samyk/openraman/cuvettes/solid/2021-11_0 - COUPELLE ASSY.csv

Supplier | Ref | Label | Qty | Price | Price Tot
Thorlabs | SM05RR | SM05 Retaining Ring for Ø1/2" Lens Tubes and Mounts | 1 | € 3.75 | € 3.75
Materialize | #2021-10/0 | COUPELLE | 1 | € 14.15 | € 14.15
FIERS | PP58.1 | Micro-capsules en aluminium forme ronde 0.035 ml (250 pcs) | 0.004 | € 105.31 | € 0.42
