samyk/openraman/cuvettes/liquid/STEP/2020-10_1 - CUVETTE HOLDER ASSY.STEP

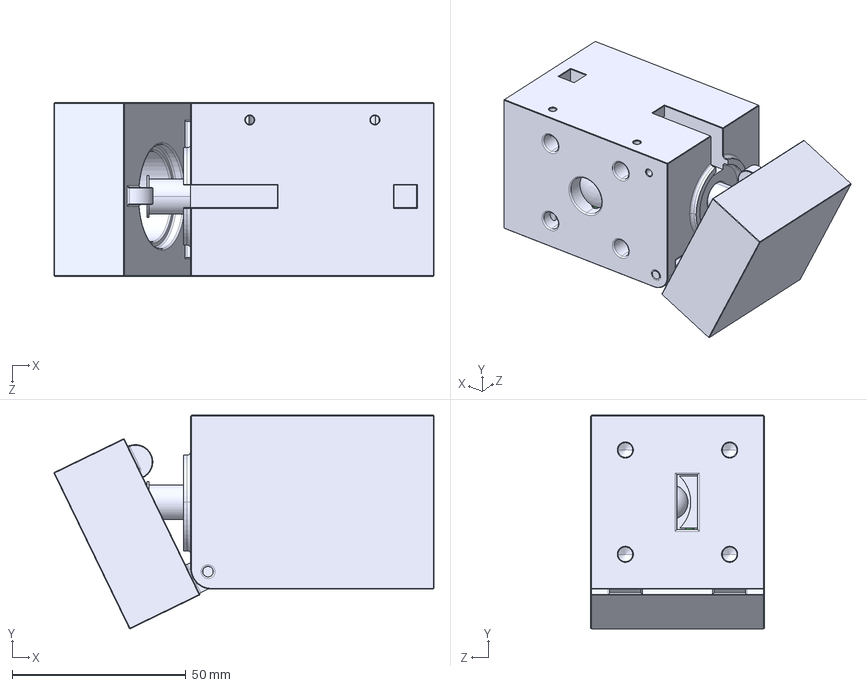
[picture p4: CAD file, 2023-12-25]
cuvettes/liquid/STEP/2020-10_1 - CUVETTE HOLDER ASSY.STEP
109.3 x 61.4 x 50.0 mm
2020-08 - CUVETTE HOLDER BODY
2020-11 - CUVETTE HOLDER OPTICAL DESIGN
2020-09 - CUVETTE HOLDER CAP
axis
tube
SS4MN4 x 2
