samyk/openraman/cuvettes/solid/STEP/2021-11_0 - COUPELLE ASSY.STEP

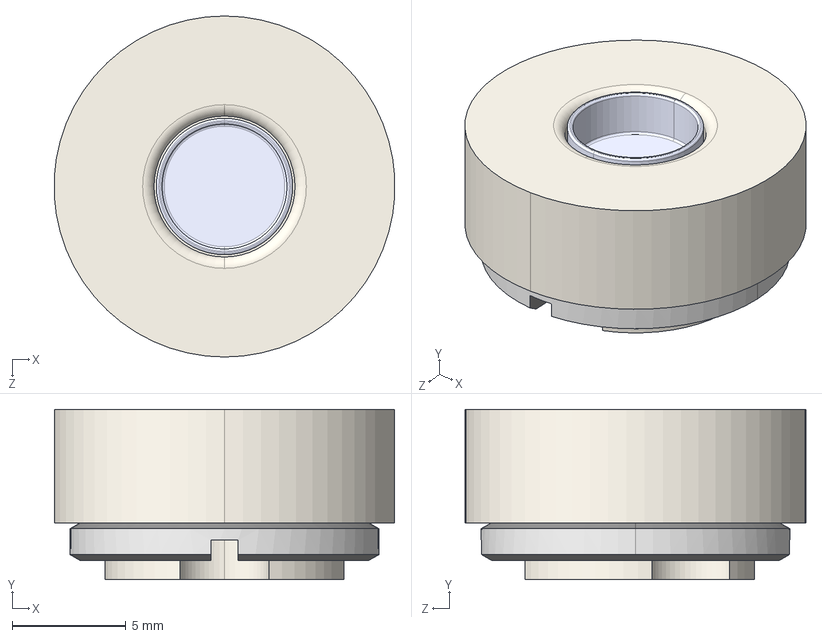
[picture p5: CAD file, 2023-12-25]
cuvettes/solid/STEP/2021-11_0 - COUPELLE ASSY.STEP
15.0 x 7.50 x 15.0 mm
2021-10 - COUPELLE
PP58.1
SM05RR
