samyk/openraman/cuvettes/liquid/STEP/2020-08_0 - CUVETTE HOLDER BODY.STEP

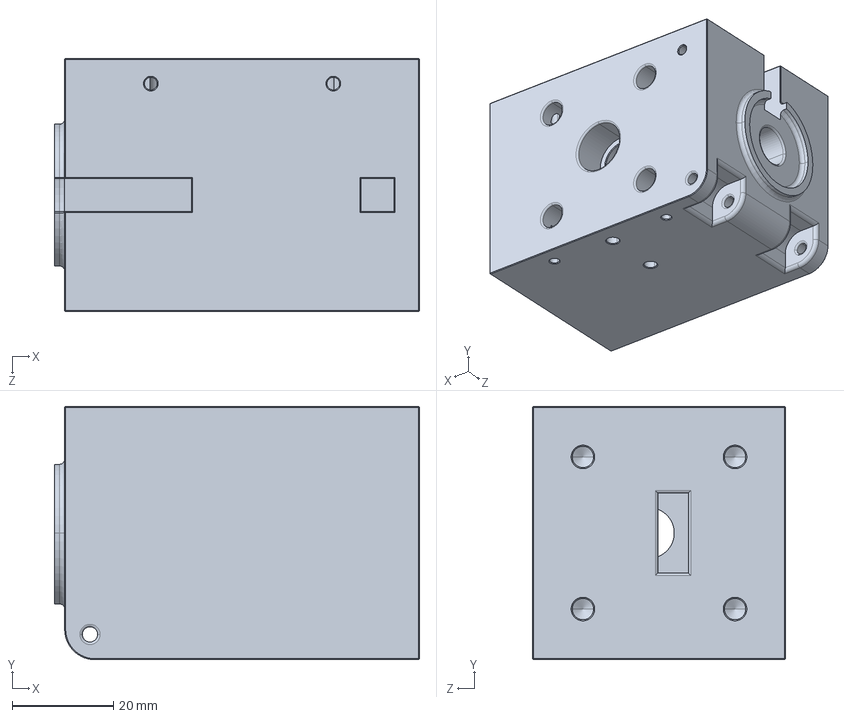
[picture p6: CAD file, 2023-12-25]
cuvettes/liquid/STEP/2020-08_0 - CUVETTE HOLDER BODY.STEP
72.0 x 50.0 x 50.0 mm
