samyk/openraman/cuvettes/solid/STEP/2021-10_0 - COUPELLE.STEP

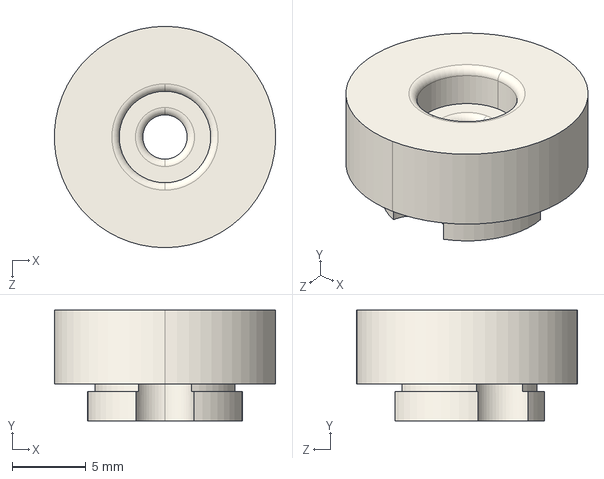
[picture p7: CAD file, 2023-12-25]
cuvettes/solid/STEP/2021-10_0 - COUPELLE.STEP
15.0 x 7.50 x 15.0 mm
