samyk/openraman/performance/STEP/2020-15_1 - GRATING HOLDER.STEP

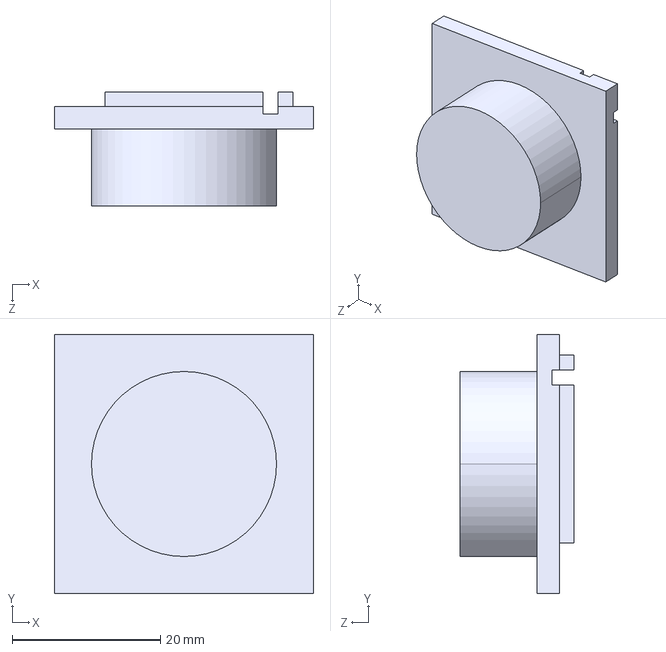
[picture p8: CAD file, 2023-12-25]
performance/STEP/2020-15_1 - GRATING HOLDER.STEP
35.0 x 35.0 x 15.4 mm
