samyk/openraman/cuvettes/solid/STEP/2021-13_0 - MICROMETER FLAT.STEP

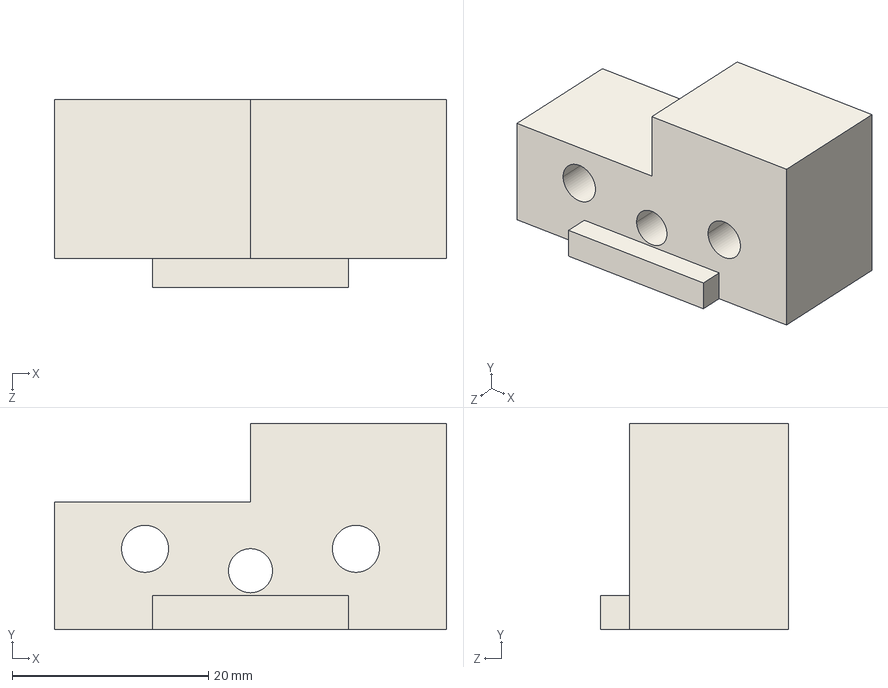
[picture p9: CAD file, 2023-12-25]
cuvettes/solid/STEP/2021-13_0 - MICROMETER FLAT.STEP
40.0 x 21.0 x 19.2 mm
