samyk/openraman/cuvettes/liquid/STEP/2020-09_0 - CUVETTE HOLDER CAP.STEP

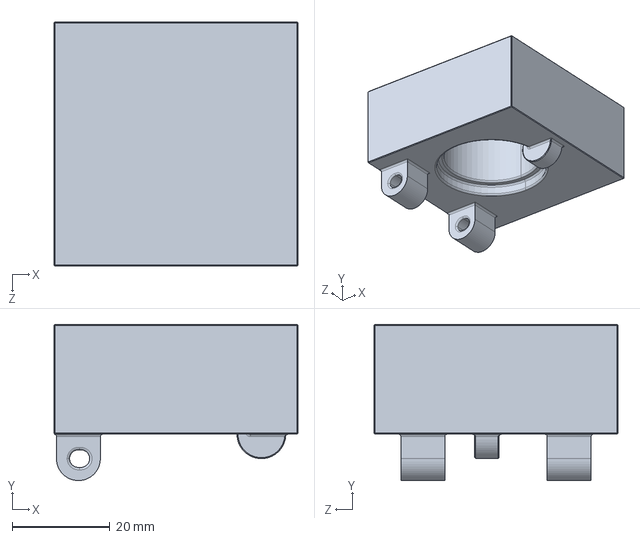
[picture p11: CAD file, 2023-12-25]
cuvettes/liquid/STEP/2020-09_0 - CUVETTE HOLDER CAP.STEP
50.0 x 32.0 x 50.0 mm
