samyk/openraman/cuvettes/solid/STEP/2021-12_0 - MICROMETER CLAMP.STEP

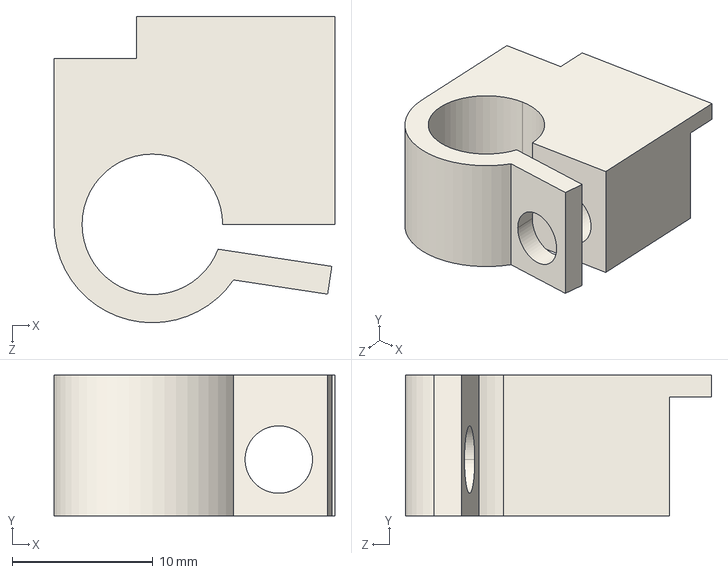
[picture p12: CAD file, 2023-12-25]
cuvettes/solid/STEP/2021-12_0 - MICROMETER CLAMP.STEP
20.0 x 10.0 x 21.8 mm
