samyk/openraman/performance/STEP/2020-20_1 - TO92 HEATSINK.STEP

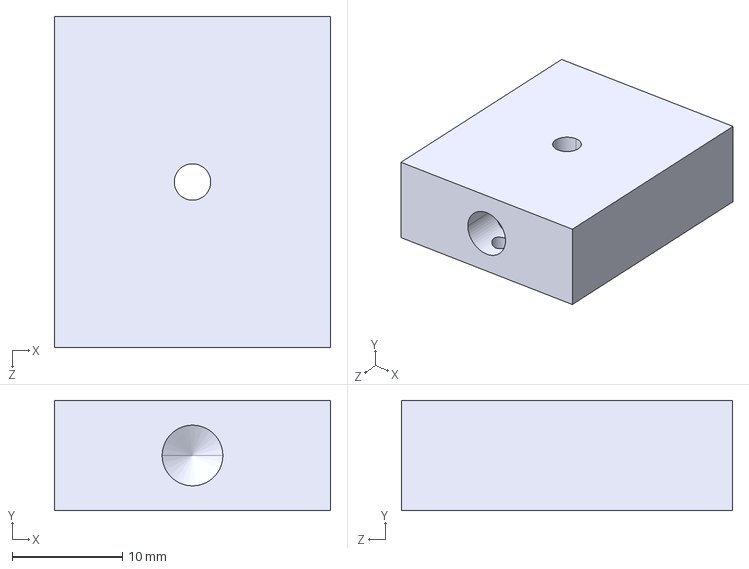
[picture p14: CAD file, 2023-12-25]
performance/STEP/2020-20_1 - TO92 HEATSINK.STEP
25.0 x 10.0 x 30.0 mm
