samyk/openraman/performance/STEP/2021-01_0 - CABLES FLEXTURE.STEP

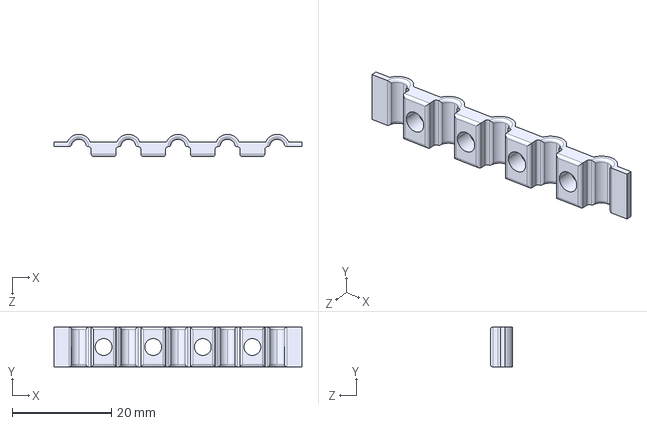
[picture p15: CAD file, 2023-12-25]
performance/STEP/2021-01_0 - CABLES FLEXTURE.STEP
50.0 x 8.00 x 4.50 mm
