samyk/openraman/performance/STEP/2020-02_2 - BASE PLATE.STEP

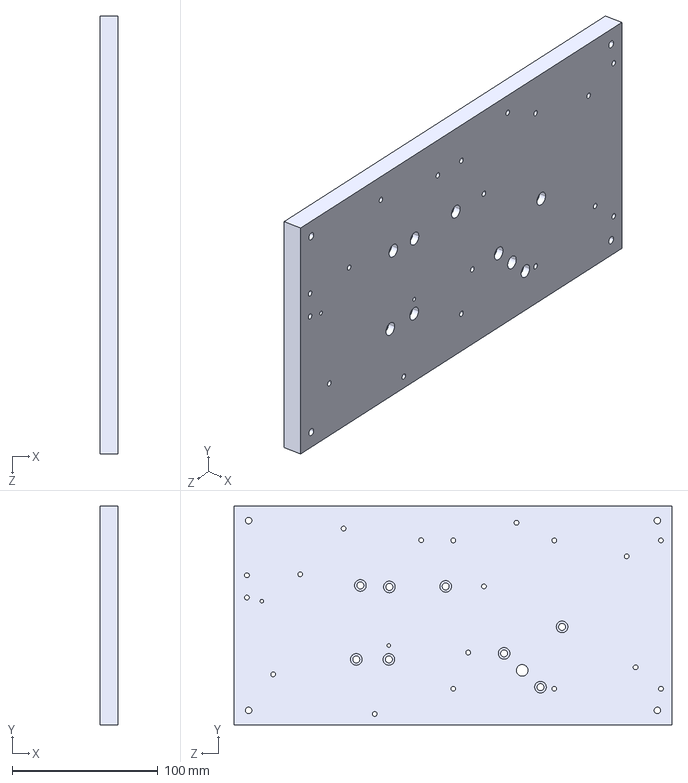
[picture p16: CAD file, 2023-12-25]
performance/STEP/2020-02_2 - BASE PLATE.STEP
12.0 x 150.0 x 300.0 mm
