samyk/openraman/performance/PDF/2020-02_2 - BASE PLATE.PDF

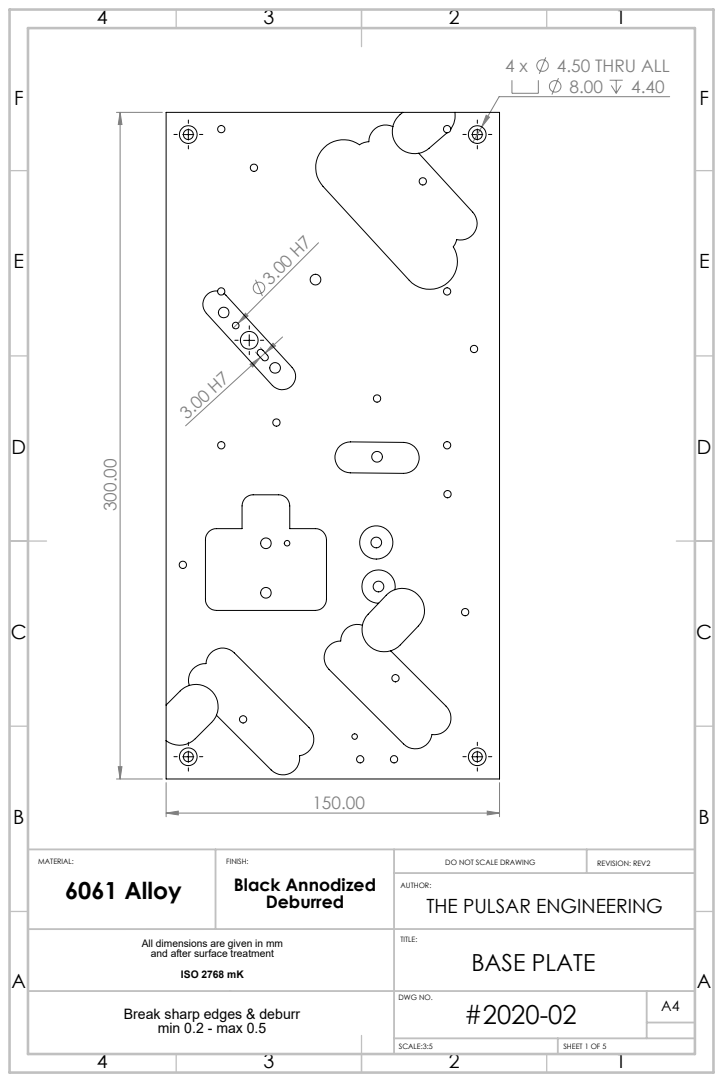
[picture p37: page 1]
4.50 THRU ALL; MATERIAL:; DO NOT SCALE DRAWING; REVISION: REV2; SCALE:3:5; SHEET 1 OF 5; 6061 Alloy; Black Annodized

AUTHOR:
THE PULSAR ENGINEERING

All dimensions are given in mm and after surface treatment ISO 2768 mK | TITLE: BASE PLATE

Break sharp edges & deburr min 0.2 - max 0.5 | DWG NO. | A4

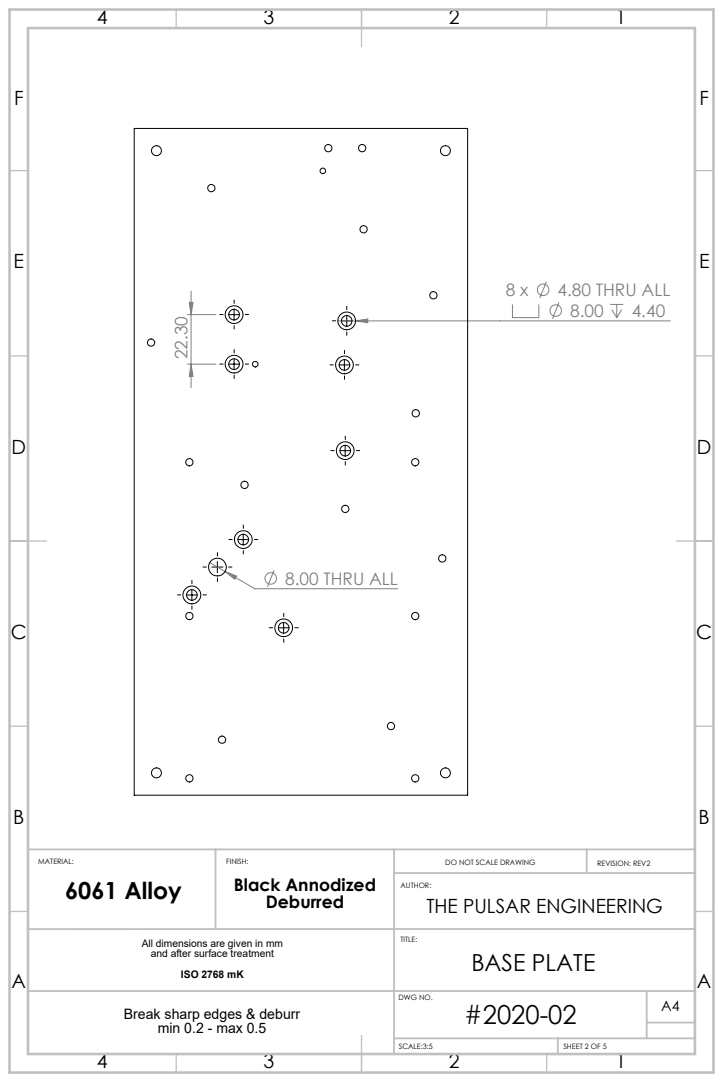
[picture p38: page 2]
4.80 THRU ALL; 8.00 THRU ALL; MATERIAL:; DO NOT SCALE DRAWING; REVISION: REV2; 6061 Alloy; Black Annodized

AUTHOR:
THE PULSAR ENGINEERING
BASE PLATE

All dimensions are given in mm
and after surface treatment
ISO 2768 mK

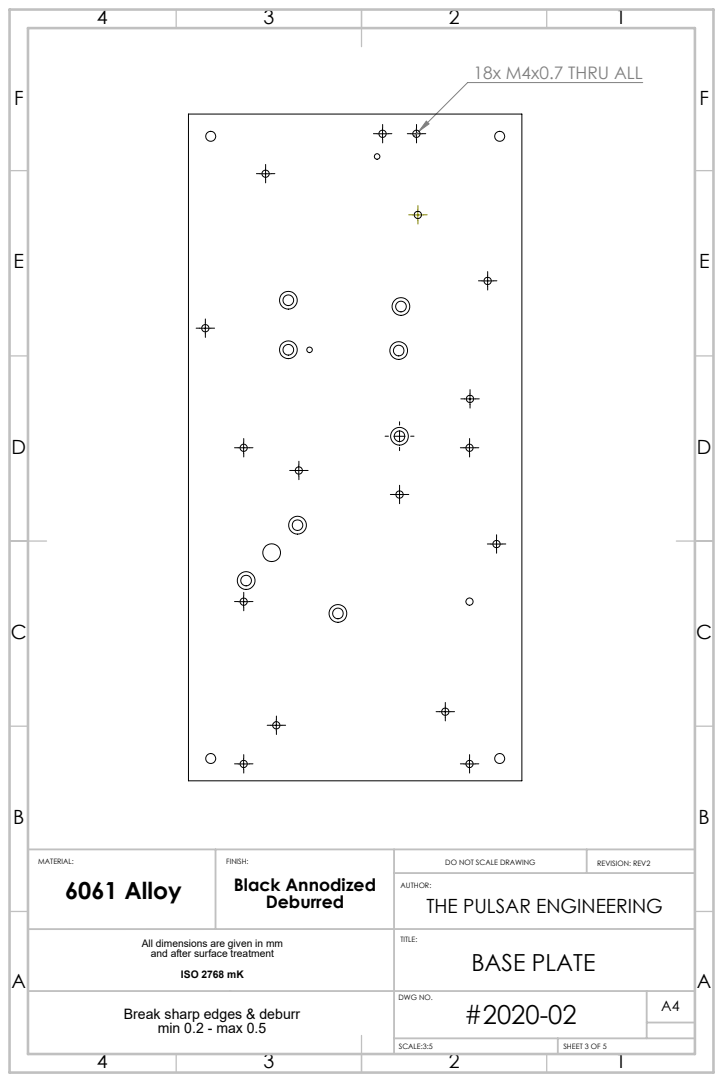
[picture p39: page 3]
18x M4x0.7 THRU ALL; MATERIAL:; DO NOT SCALE DRAWING; REVISION: REV2; 6061 Alloy; Black Annodized

AUTHOR:
THE PULSAR ENGINEERING
BASE PLATE

All dimensions are given in mm
and after surface treatment
ISO 2768 mK

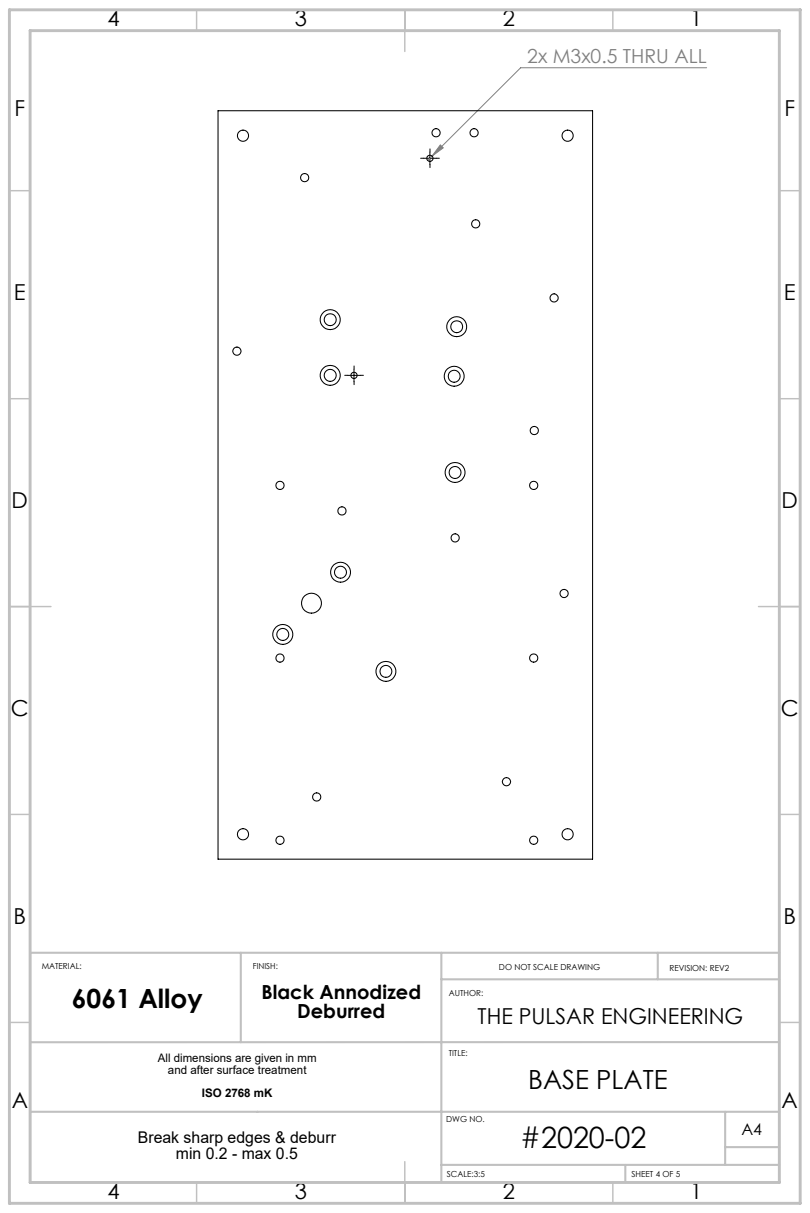
[picture p40: page 4]
2x M3x0.5 THRU ALL; MATERIAL:; DO NOT SCALE DRAWING; REVISION: REV2; 6061 Alloy; Black Annodized

AUTHOR:
THE PULSAR ENGINEERING
BASE PLATE

All dimensions are given in mm
and after surface treatment
ISO 2768 mK

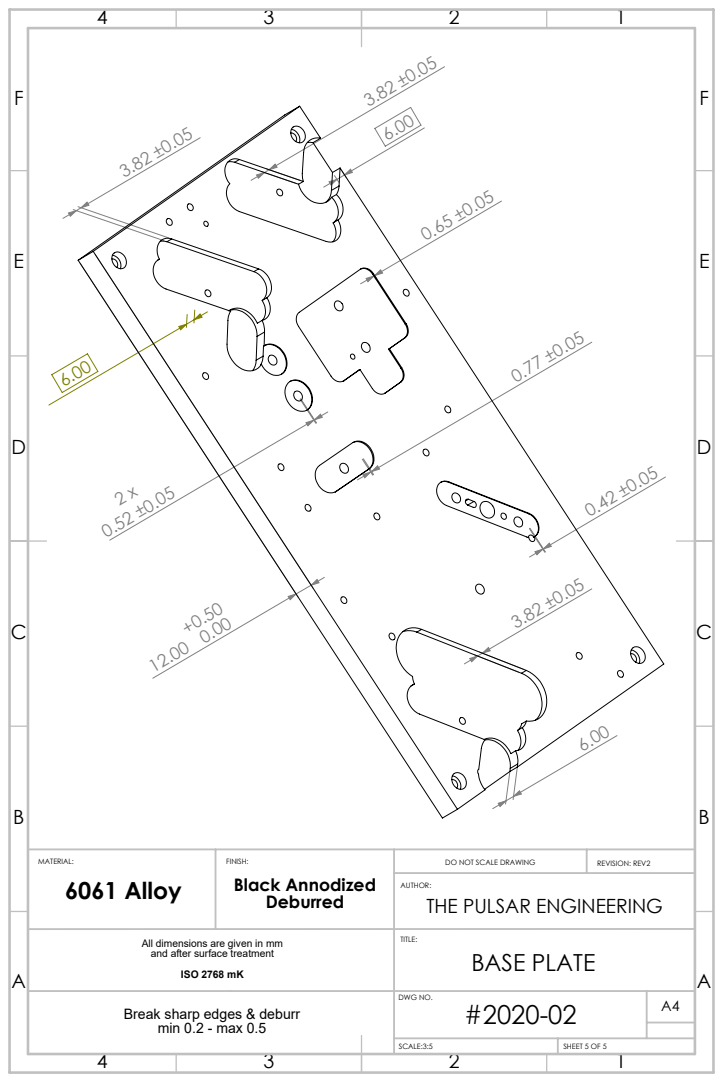
[picture p41: page 5]
MATERIAL:; DO NOT SCALE DRAWING; REVISION: REV2; 6061 Alloy; Black Annodized

AUTHOR:
THE PULSAR ENGINEERING
BASE PLATE

All dimensions are given in mm
and after surface treatment
ISO 2768 mK
