samyk/openraman/performance/PDF/2020-04_2 - PERFORMANCE EDITION ASSY.PDF

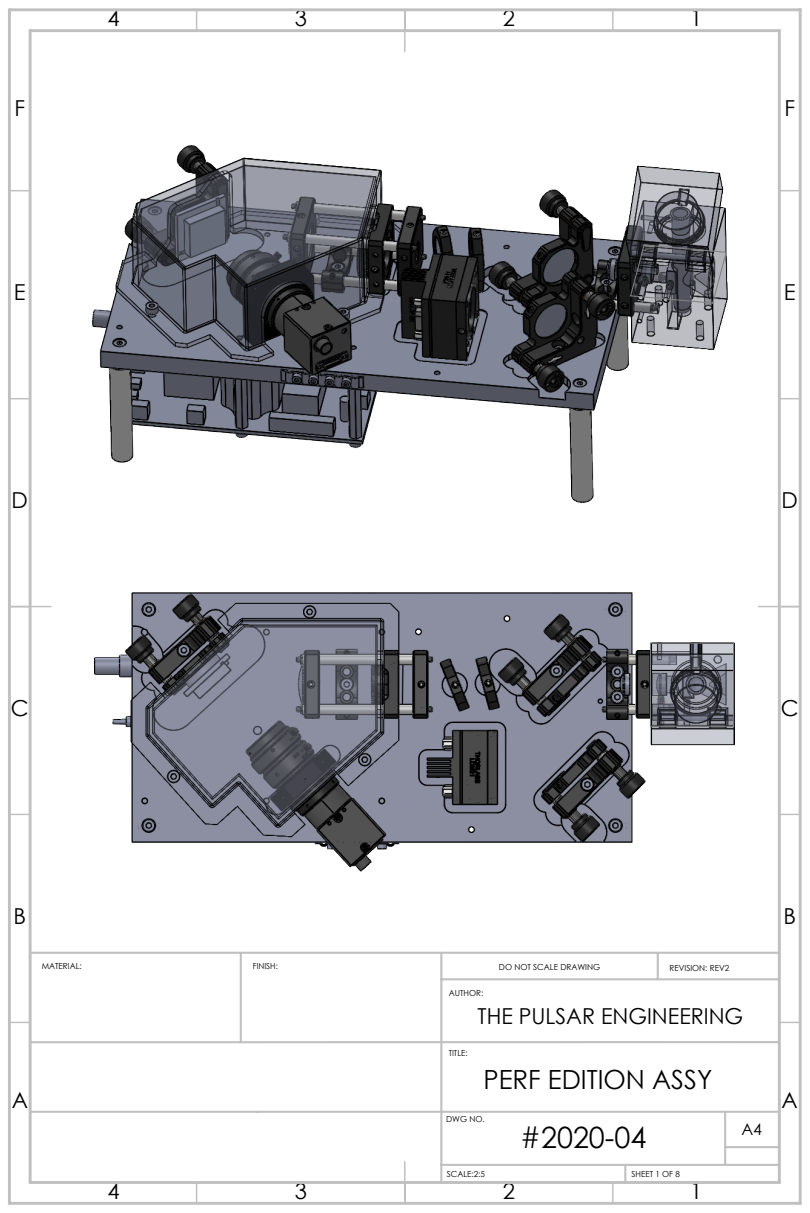
[picture p42: page 1]
MATERIAL:; FINISH:; DO NOT SCALE DRAWING; REVISION: REV2; SCALE:2:5; SHEET 1 OF 8

AUTHOR:
THE PULSAR ENGINEERING

TITLE: PERF EDITION ASSY

DWG NO. | A4

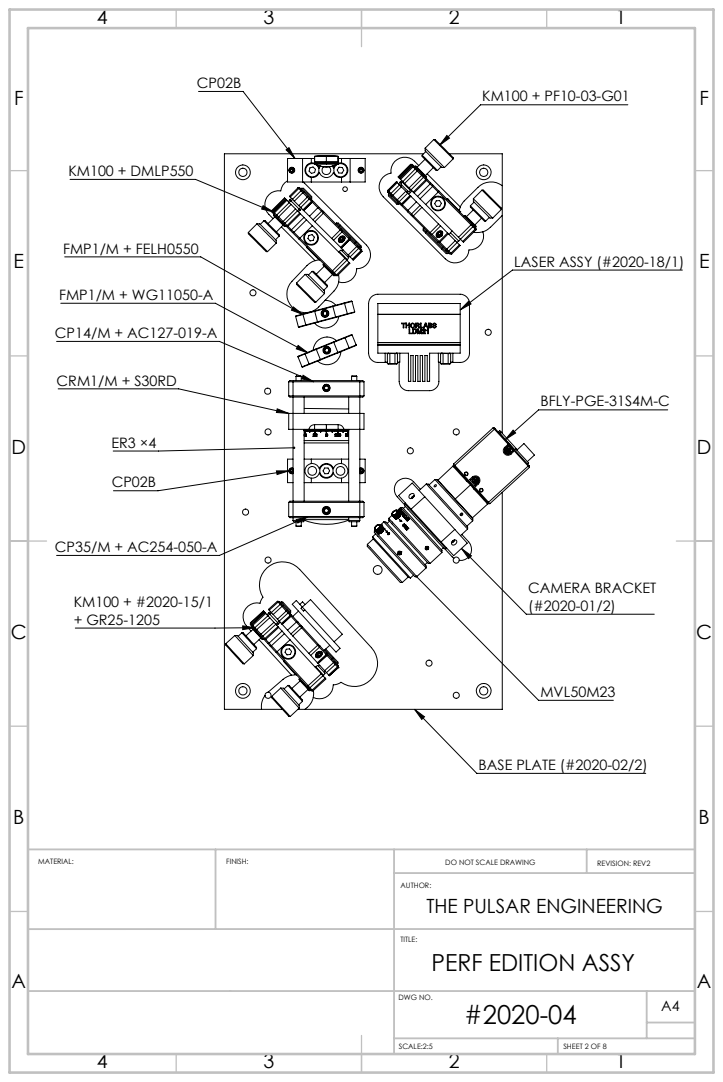
[picture p43: page 2]
LASER ASSY (#2020-18/1); CAMERA BRACKET; BASE PLATE (#2020-02/2); CRM1/M + S30RD; FMP1/M + WG11050-A; FMP1/M + FELH0550; KM100 + DMLP550; MATERIAL:; FINISH:; DO NOT SCALE DRAWING; REVISION: REV2

AUTHOR:
THE PULSAR ENGINEERING
PERF EDITION ASSY

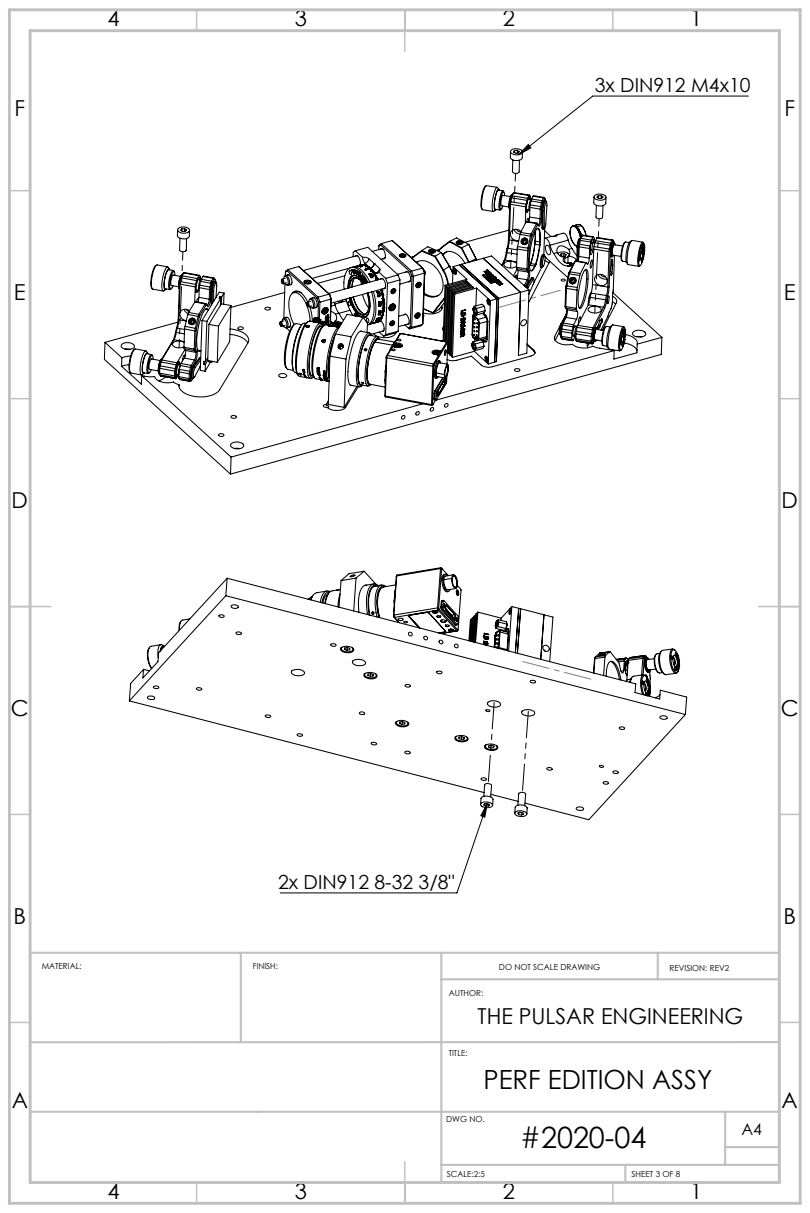
[picture p44: page 3]
3x DIN912 M4x10; 2x DIN912 8-32 3/8"; MATERIAL:; FINISH:; DO NOT SCALE DRAWING; REVISION: REV2

AUTHOR:
THE PULSAR ENGINEERING
PERF EDITION ASSY

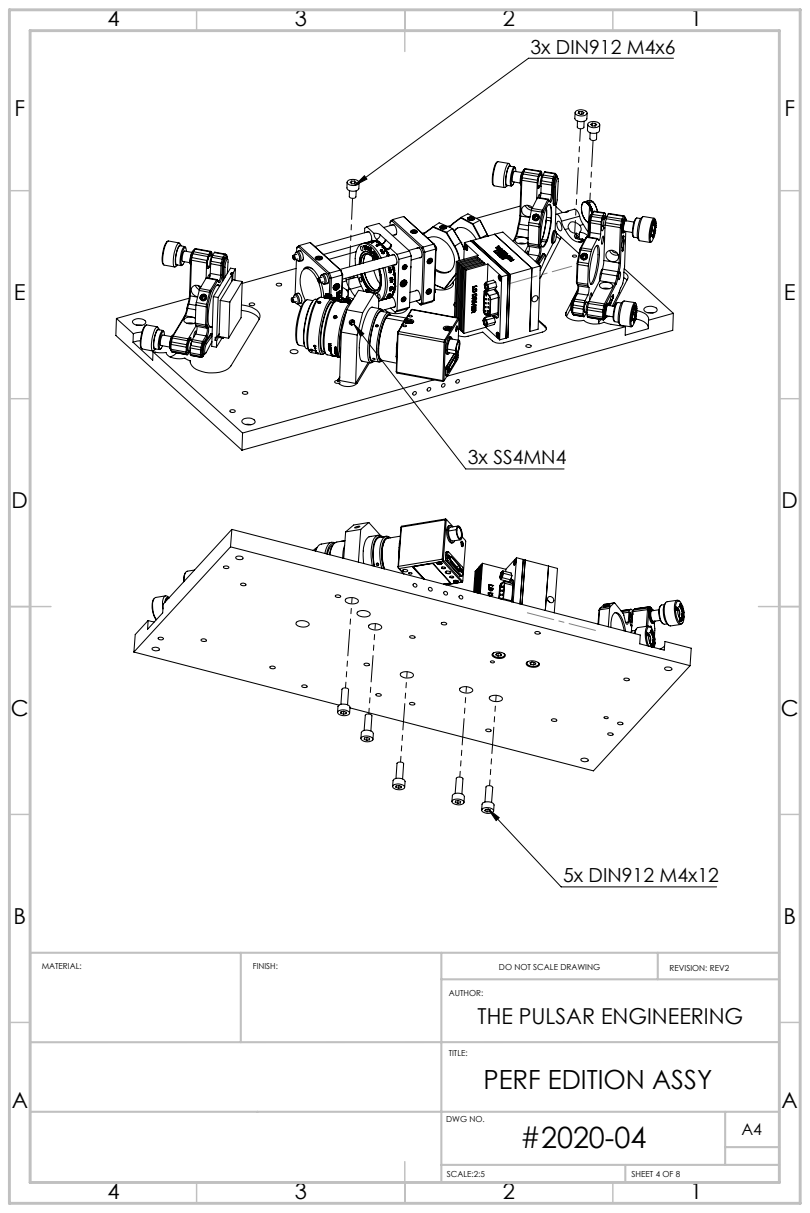
[picture p45: page 4]
3x DIN912 M4x6; 5x DIN912 M4x12; MATERIAL:; FINISH:; DO NOT SCALE DRAWING; REVISION: REV2

AUTHOR:
THE PULSAR ENGINEERING
PERF EDITION ASSY

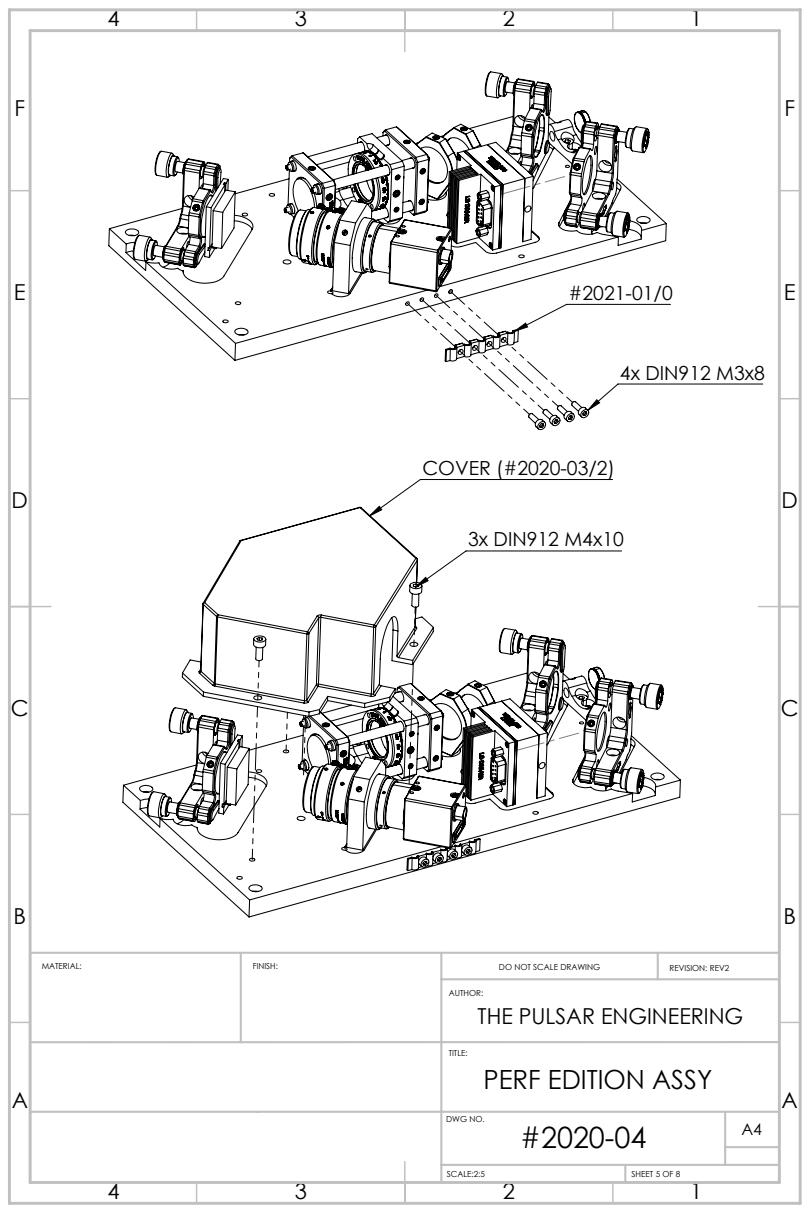
[picture p46: page 5]
4x DIN912 M3x8; COVER (#2020-03/2); 3x DIN912 M4x10; MATERIAL:; FINISH:; DO NOT SCALE DRAWING; REVISION: REV2

AUTHOR:
THE PULSAR ENGINEERING
PERF EDITION ASSY

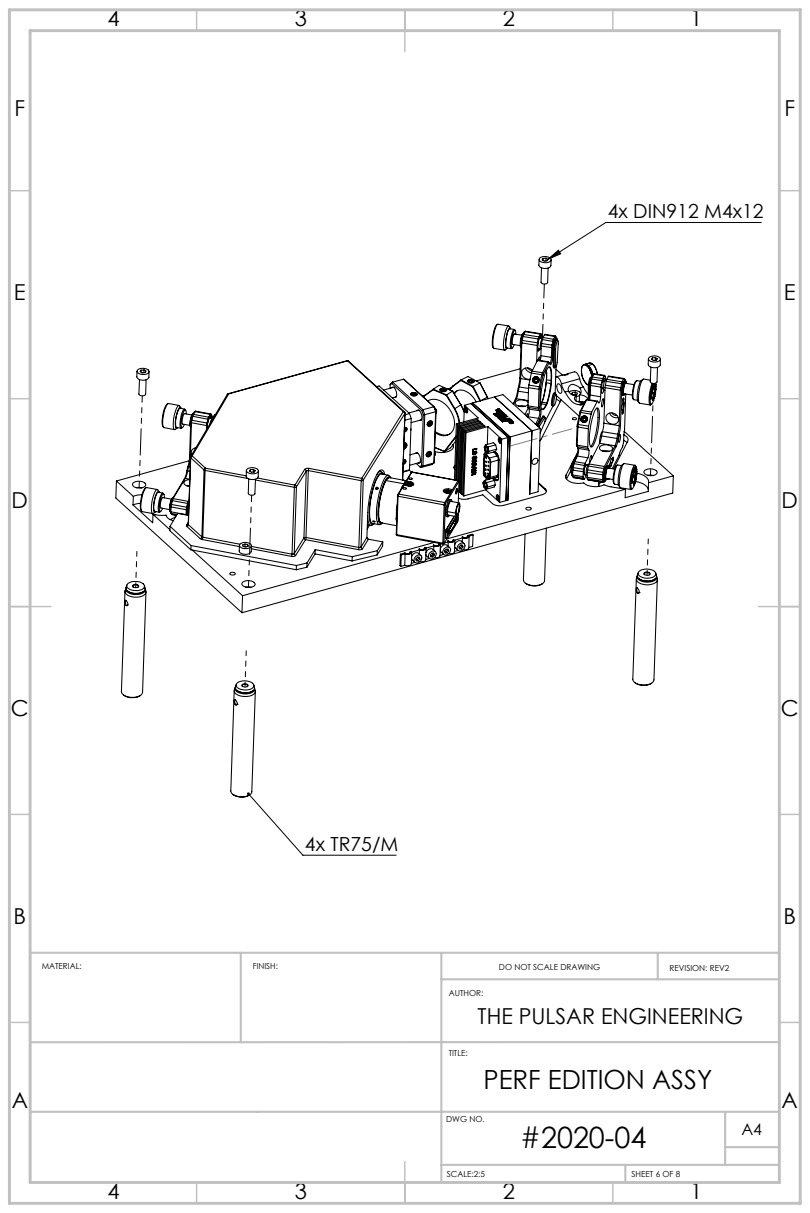
[picture p47: page 6]
4x DIN912 M4x12; MATERIAL:; FINISH:; DO NOT SCALE DRAWING; REVISION: REV2

AUTHOR:
THE PULSAR ENGINEERING
PERF EDITION ASSY

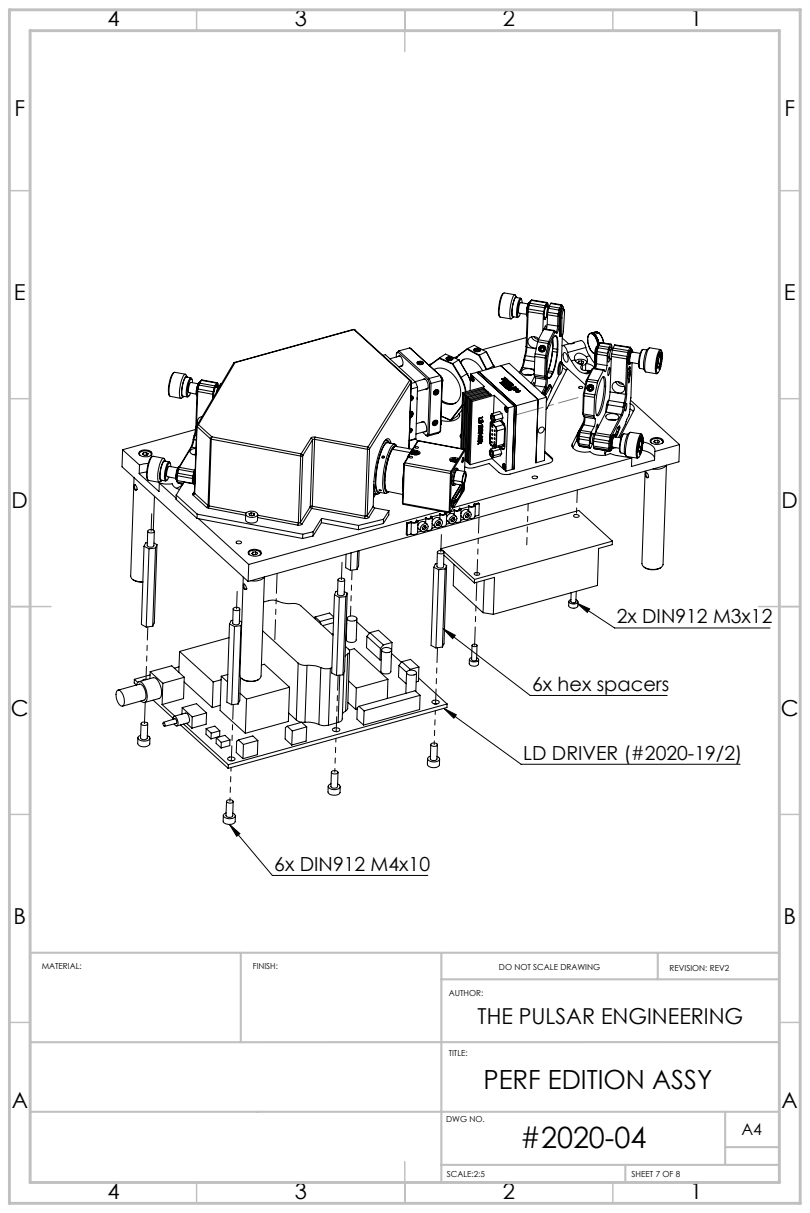
[picture p48: page 7]
LD DRIVER (#2020-19/2); 2x DIN912 M3x12; 6x DIN912 M4x10; 6x hex spacers; MATERIAL:; FINISH:; DO NOT SCALE DRAWING; REVISION: REV2

AUTHOR:
THE PULSAR ENGINEERING
PERF EDITION ASSY

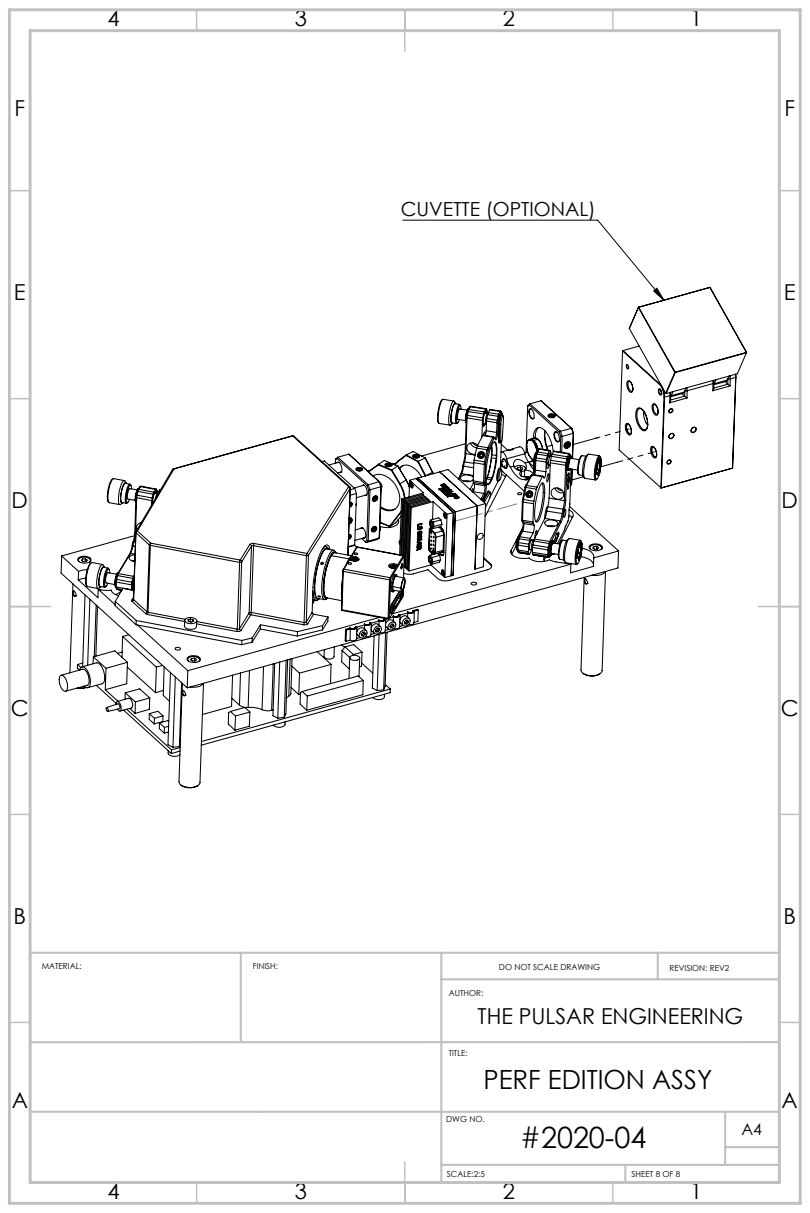
[picture p49: page 8]
CUVETTE (OPTIONAL); MATERIAL:; FINISH:; DO NOT SCALE DRAWING; REVISION: REV2

AUTHOR:
THE PULSAR ENGINEERING
PERF EDITION ASSY
