samyk/openraman/performance/PDF/2020-15_1 - GRATING HOLDER.PDF

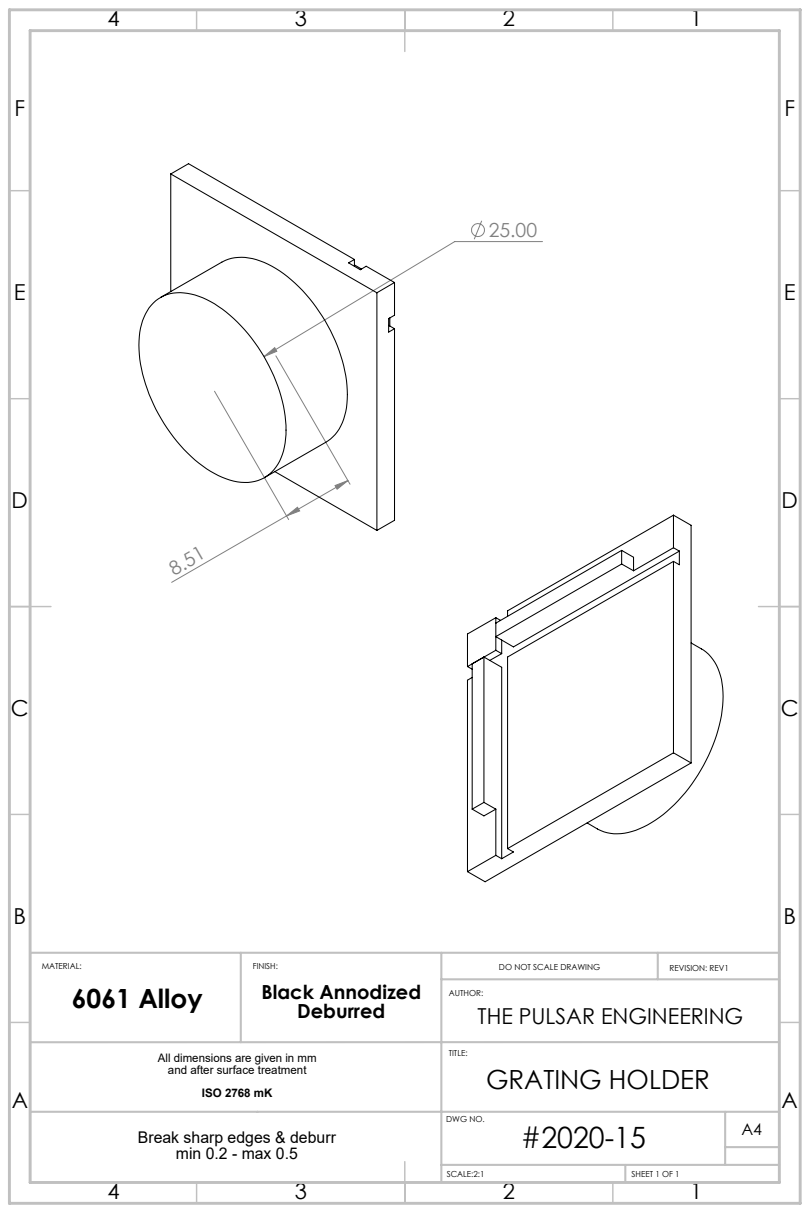
[picture p51: page 1]
MATERIAL:; DO NOT SCALE DRAWING; REVISION: REV1; SCALE:2:1; SHEET 1 OF 1; 6061 Alloy; Black Annodized

AUTHOR:
THE PULSAR ENGINEERING

All dimensions are given in mm and after surface treatment ISO 2768 mK | TITLE: GRATING HOLDER

Break sharp edges & deburr min 0.2 - max 0.5 | DWG NO. #2020-15 | A4
