samyk/openraman/performance/PDF/2020-18_1 - LASER ASSY.PDF

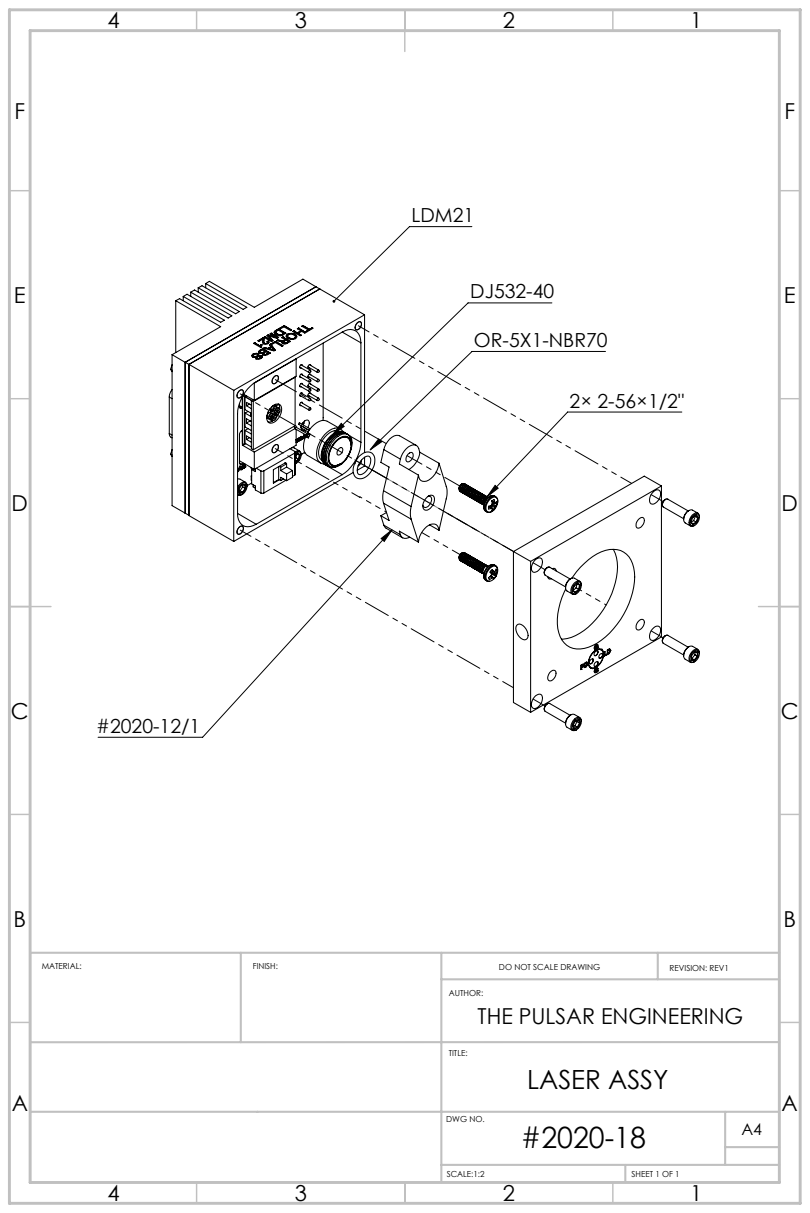
[picture p52: page 1]
MATERIAL:; FINISH:; DO NOT SCALE DRAWING; REVISION: REV1; SCALE:1:2; SHEET 1 OF 1

AUTHOR:
THE PULSAR ENGINEERING

TITLE: LASER ASSY

DWG NO. #2020-18 | A4
