samyk/openraman/performance/PDF/2020-19_2 - LD DRIVER IC.pdf

J1

## INTERLOCK

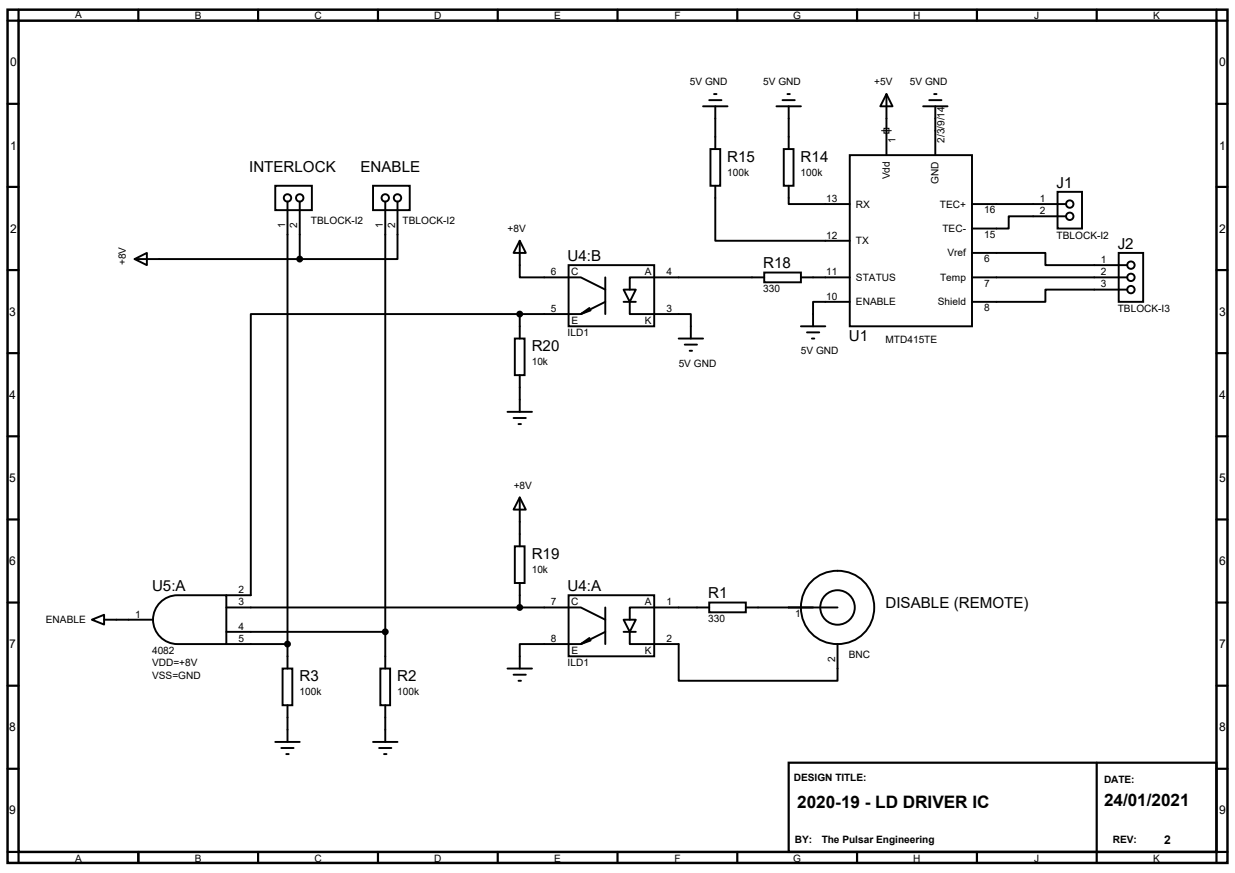
[picture p53: page 1]

5V GND 5V GND +5V 5V GND

C1

## FAN1

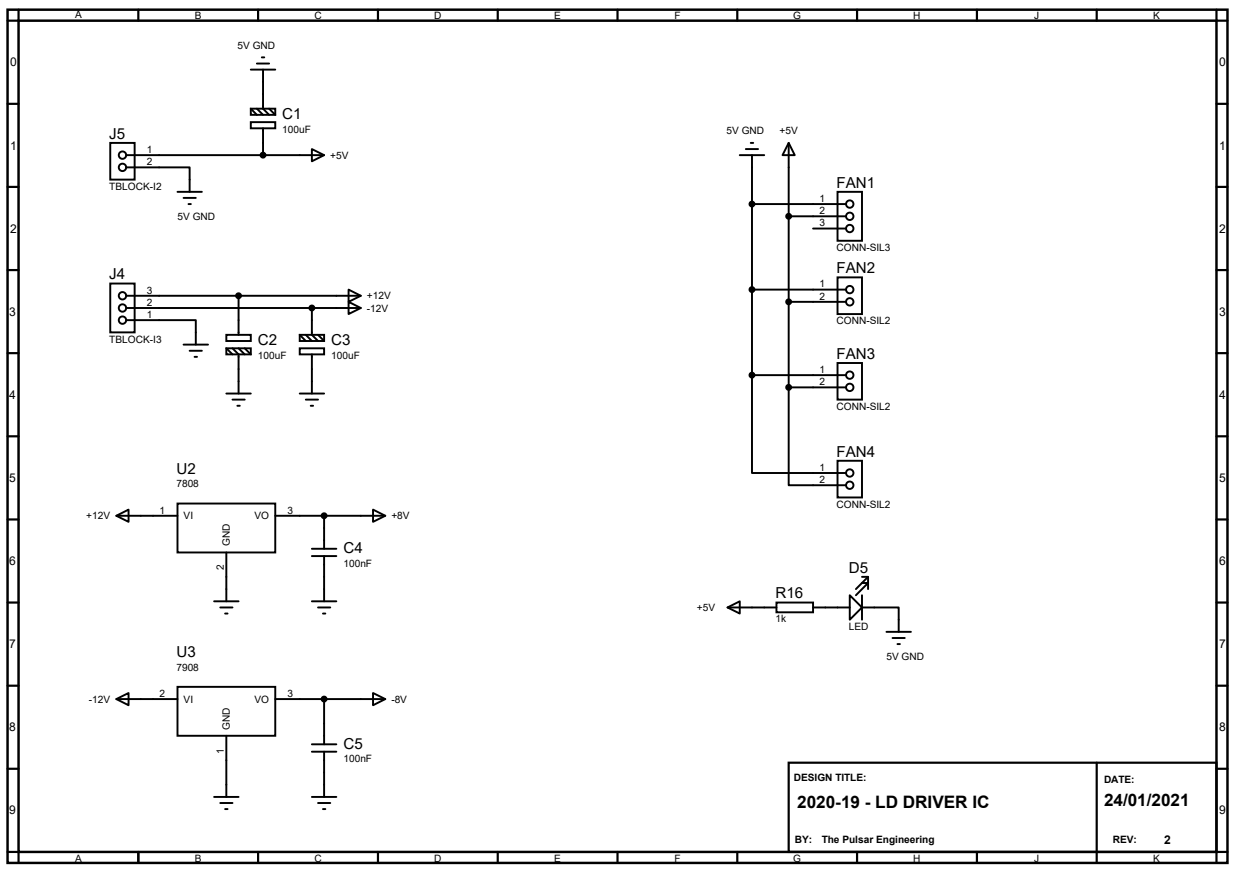
[picture p54: page 2]

R4

D6

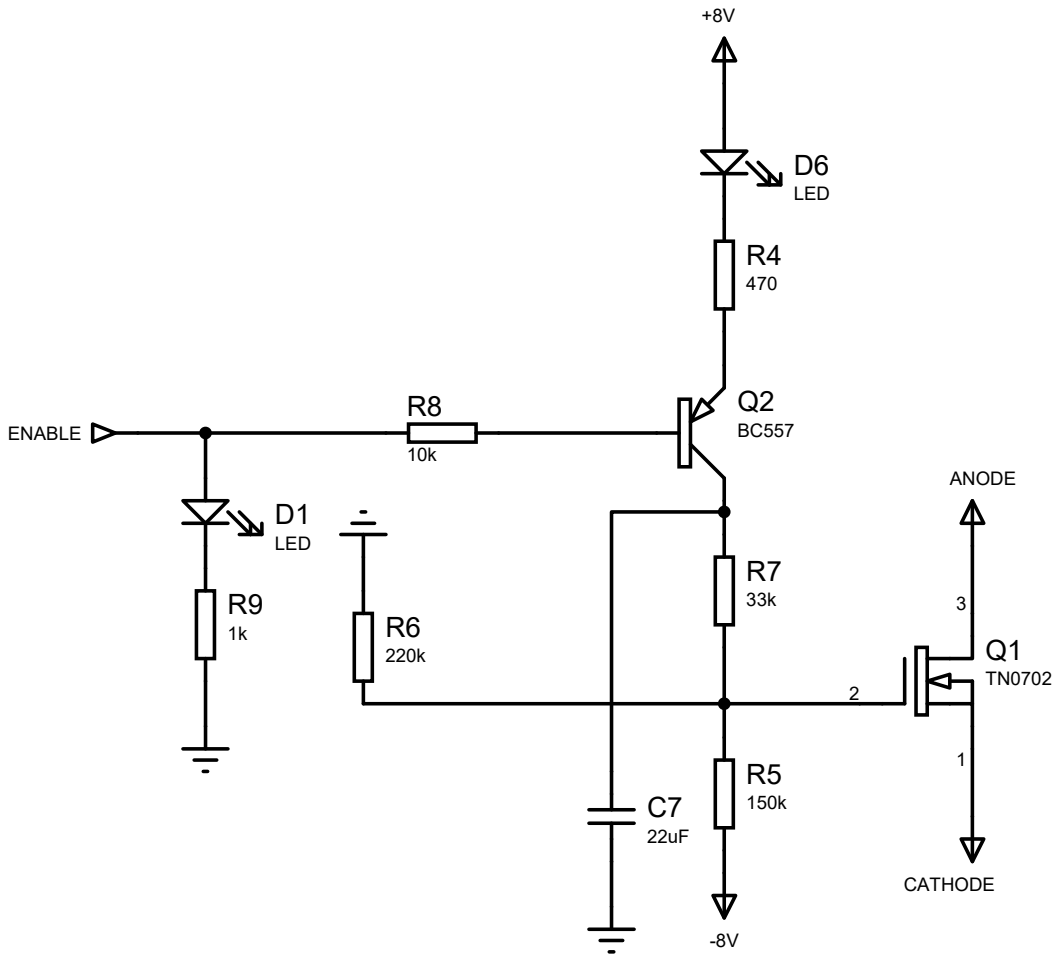
[picture p55: page 3]

U6

C8

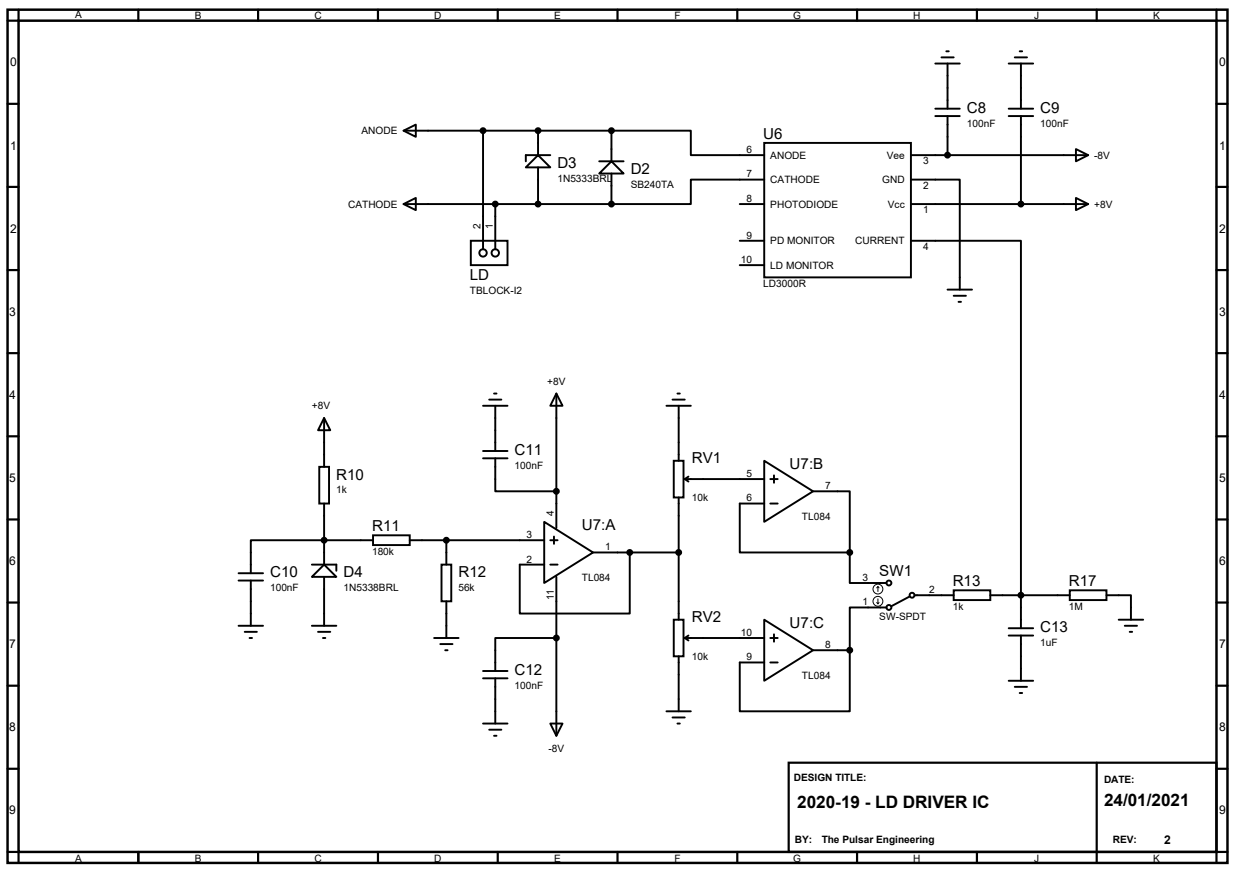
[picture p56: page 4]
