samyk/openraman/performance/PDF/2020-20_1 - TO92 HEATSINK.PDF

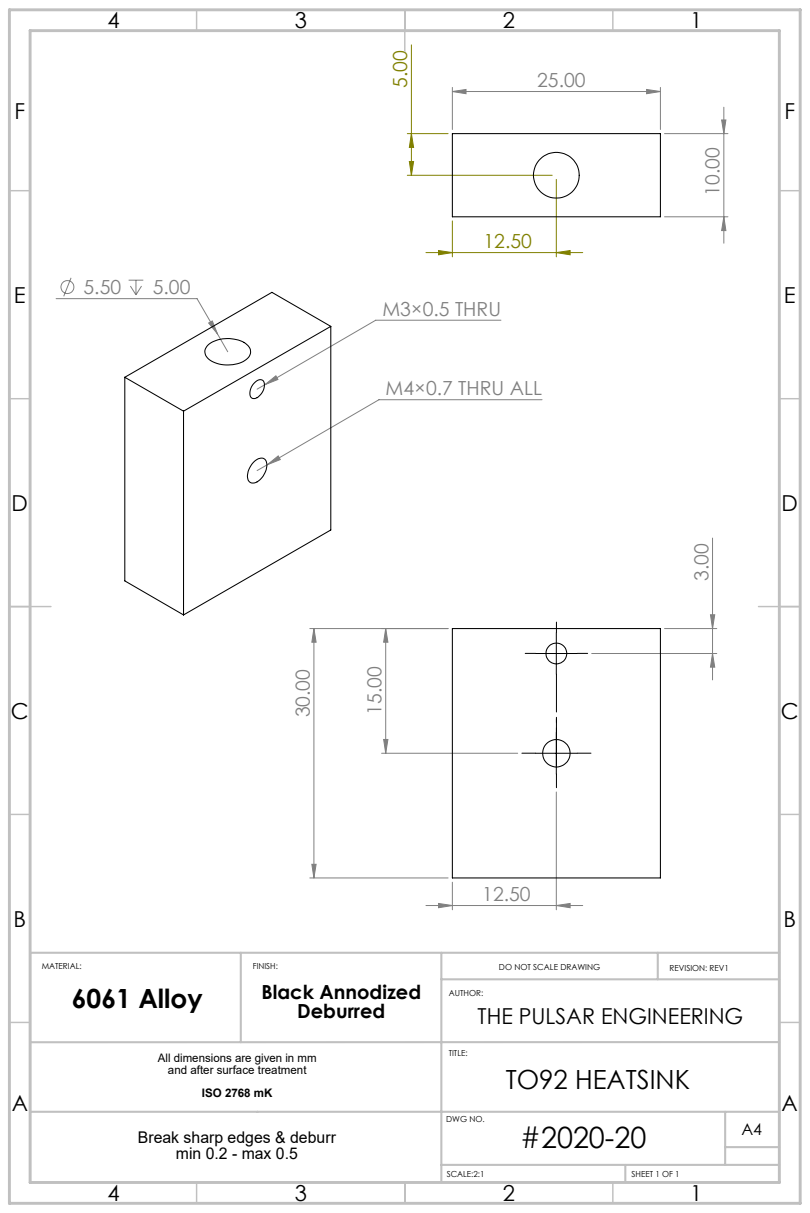
[picture p57: page 1]
M3×0.5 THRU; M4×0.7 THRU ALL; MATERIAL:; DO NOT SCALE DRAWING; REVISION: REV1; SCALE:2:1; SHEET 1 OF 1; 6061 Alloy; Black Annodized

AUTHOR:
THE PULSAR ENGINEERING

All dimensions are given in mm and after surface treatment ISO 2768 mK | TITLE: TO92 HEATSINK

Break sharp edges & deburr min 0.2 - max 0.5 | DWG NO. #2020-20 | A4
