samyk/openraman/performance/PDF/2021-01_0 - CABLES FLEXTURE.PDF

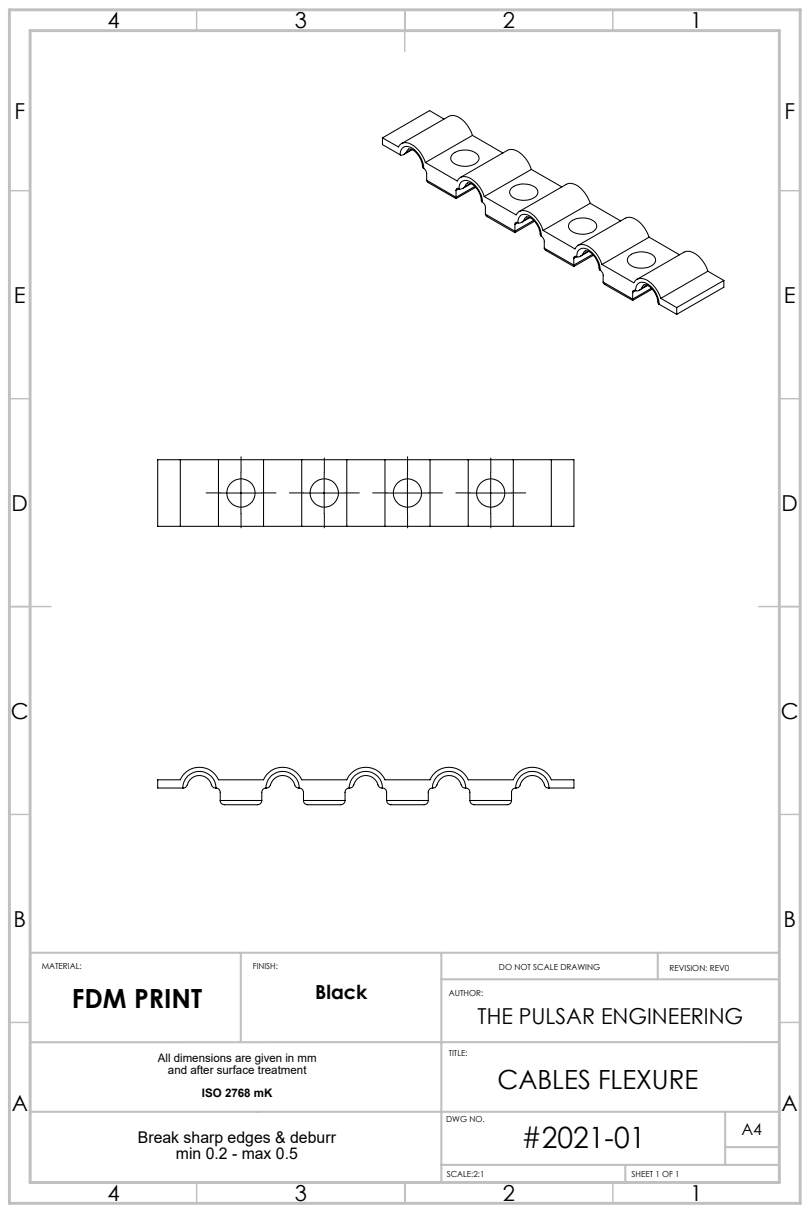
[picture p58: page 1]
MATERIAL:; DO NOT SCALE DRAWING; REVISION: REV0; SCALE:2:1; SHEET 1 OF 1; FDM PRINT; Black

AUTHOR:
THE PULSAR ENGINEERING

All dimensions are given in mm and after surface treatment ISO 2768 mK | TITLE: CABLES FLEXURE

Break sharp edges & deburr min 0.2 - max 0.5 | DWG NO. #2021-01 | A4
