samyk/openraman/cuvettes/liquid/PDF/2020-08_0 - CUVETTE HOLDER BODY.PDF

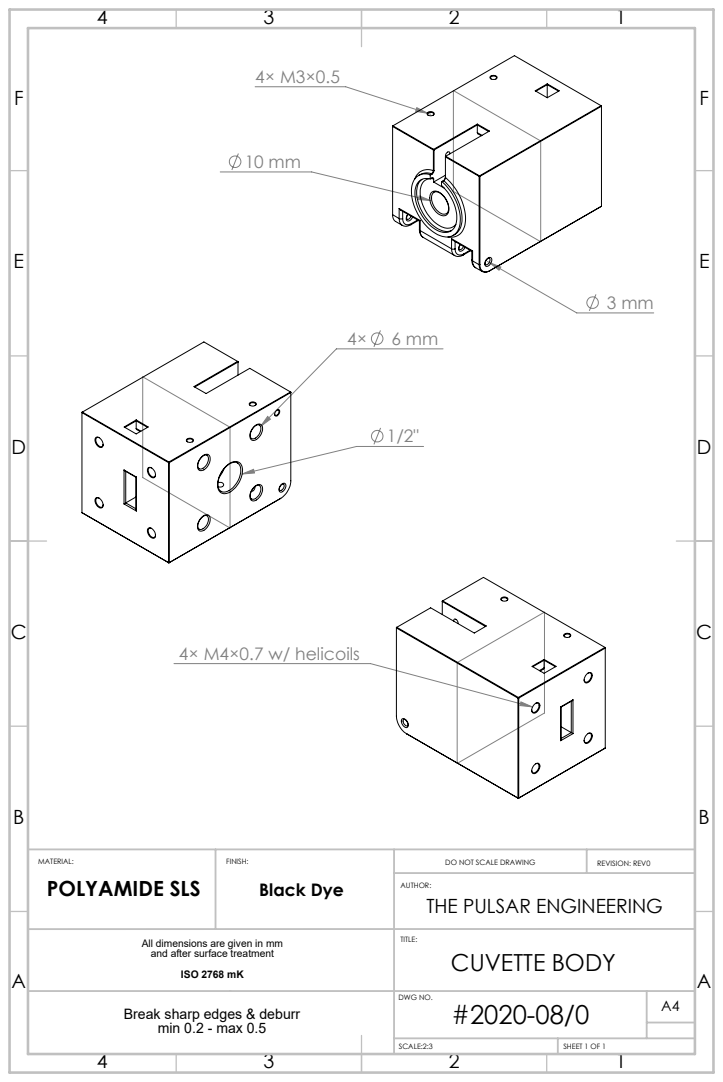
[picture p59: page 1]
4× M4×0.7 w/ helicoils; MATERIAL:; DO NOT SCALE DRAWING; REVISION: REV0; SCALE:2:3; SHEET 1 OF 1; POLYAMIDE SLS; Black Dye

AUTHOR:
THE PULSAR ENGINEERING

All dimensions are given in mm and after surface treatment ISO 2768 mK | TITLE: CUVETTE BODY

Break sharp edges & deburr min 0.2 - max 0.5 | DWG NO. #2020-08/0 | A4
