samyk/openraman/cuvettes/liquid/PDF/2020-10_1 - CUVETTE HOLDER ASSY.PDF

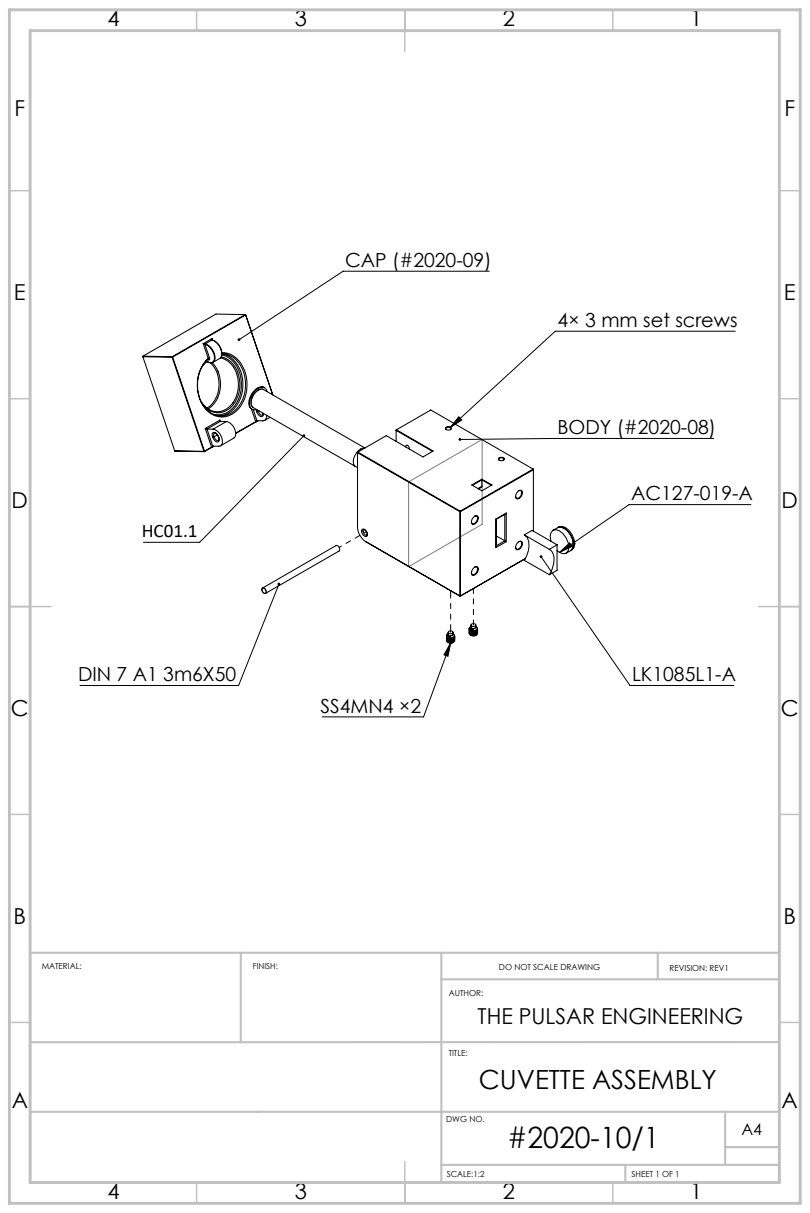
[picture p60: page 1]
CAP (#2020-09); BODY (#2020-08); DIN 7 A1 3m6X50; MATERIAL:; FINISH:; DO NOT SCALE DRAWING; REVISION: REV1; SCALE:1:2; SHEET 1 OF 1

4× 3 mm set screws

AUTHOR:
THE PULSAR ENGINEERING

TITLE: CUVETTE ASSEMBLY

DWG NO. #2020-10/1 | A4
