samyk/openraman/cuvettes/solid/PDF/2021-09_0 - SOLID ASSY.pdf

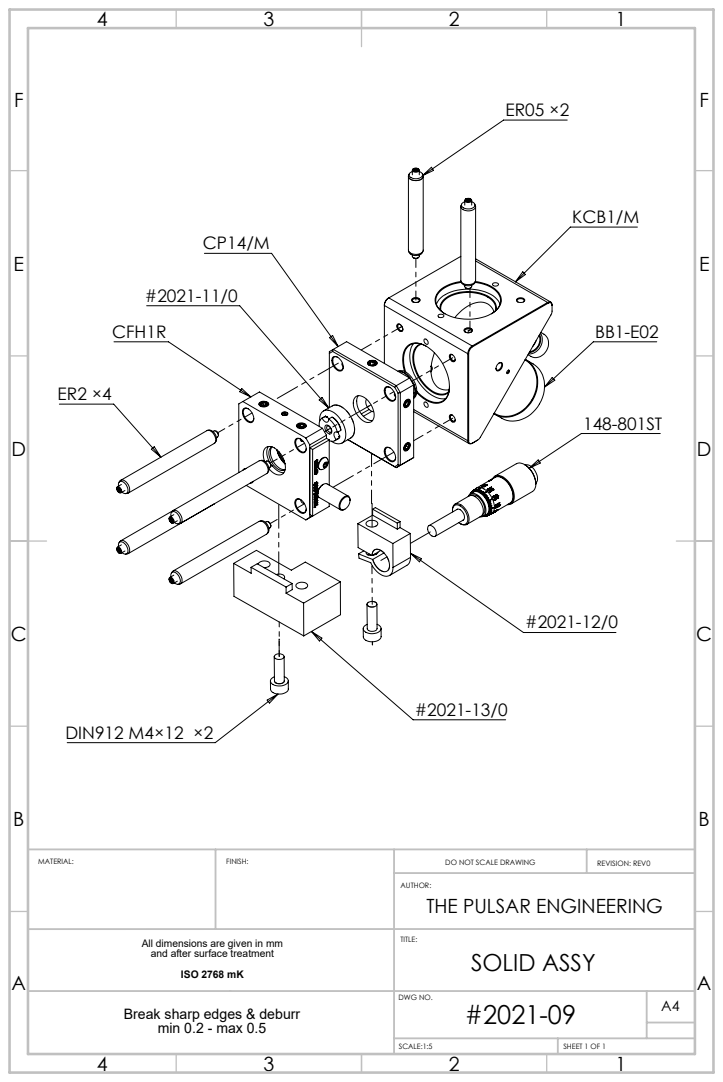
[picture p61: page 1]
DIN912 M4×12 ×2; MATERIAL:; DO NOT SCALE DRAWING; REVISION: REV0; SCALE:1:5; SHEET 1 OF 1

AUTHOR:
THE PULSAR ENGINEERING

All dimensions are given in mm and after surface treatment ISO 2768 mK | TITLE: SOLID ASSY

Break sharp edges & deburr min 0.2 - max 0.5 | DWG NO. #2021-09 | A4
