samyk/openraman/cuvettes/solid/PDF/2021-10_0 - COUPELLE.pdf

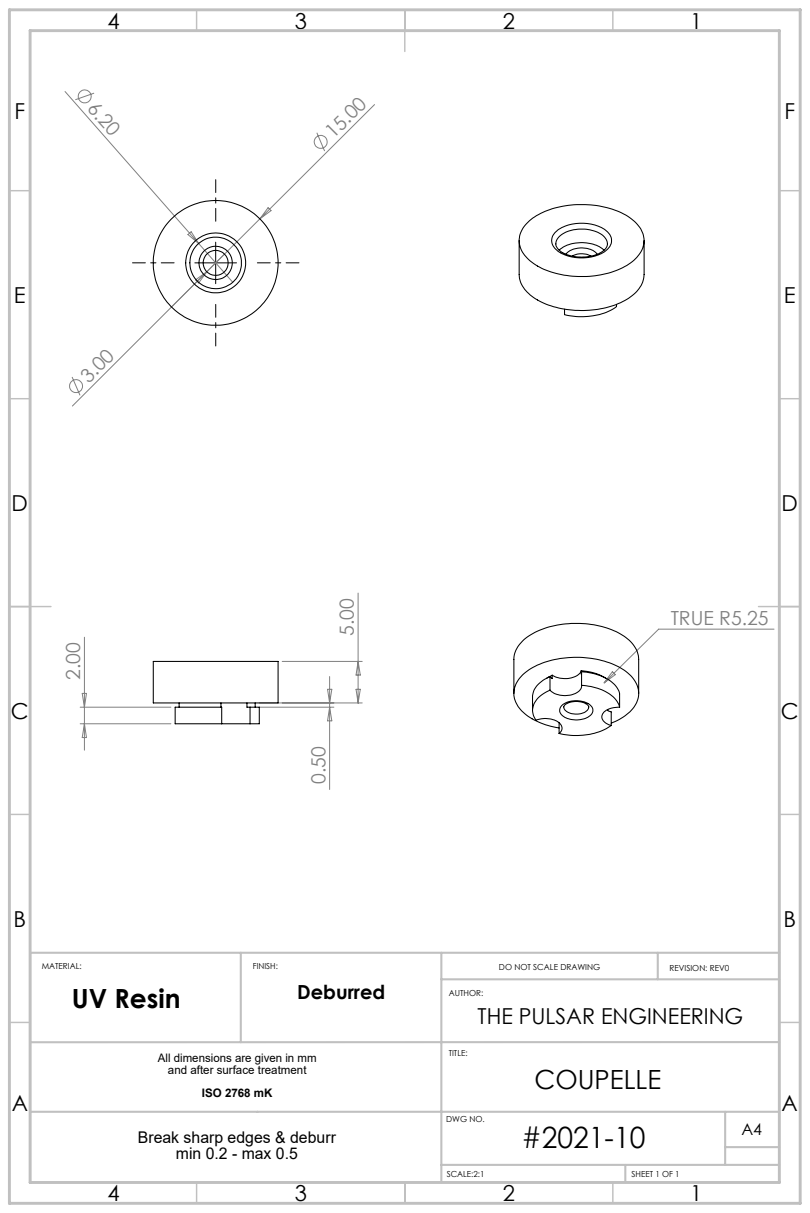
[picture p62: page 1]
TRUE R5.25; MATERIAL:; DO NOT SCALE DRAWING; REVISION: REV0; SCALE:2:1; SHEET 1 OF 1; UV Resin; Deburred

AUTHOR:
THE PULSAR ENGINEERING

All dimensions are given in mm and after surface treatment ISO 2768 mK | TITLE: COUPELLE

Break sharp edges & deburr min 0.2 - max 0.5 | DWG NO. #2021-10 | A4
