samyk/openraman/cuvettes/solid/PDF/2021-13_0 - MICROMETER FLAT.pdf

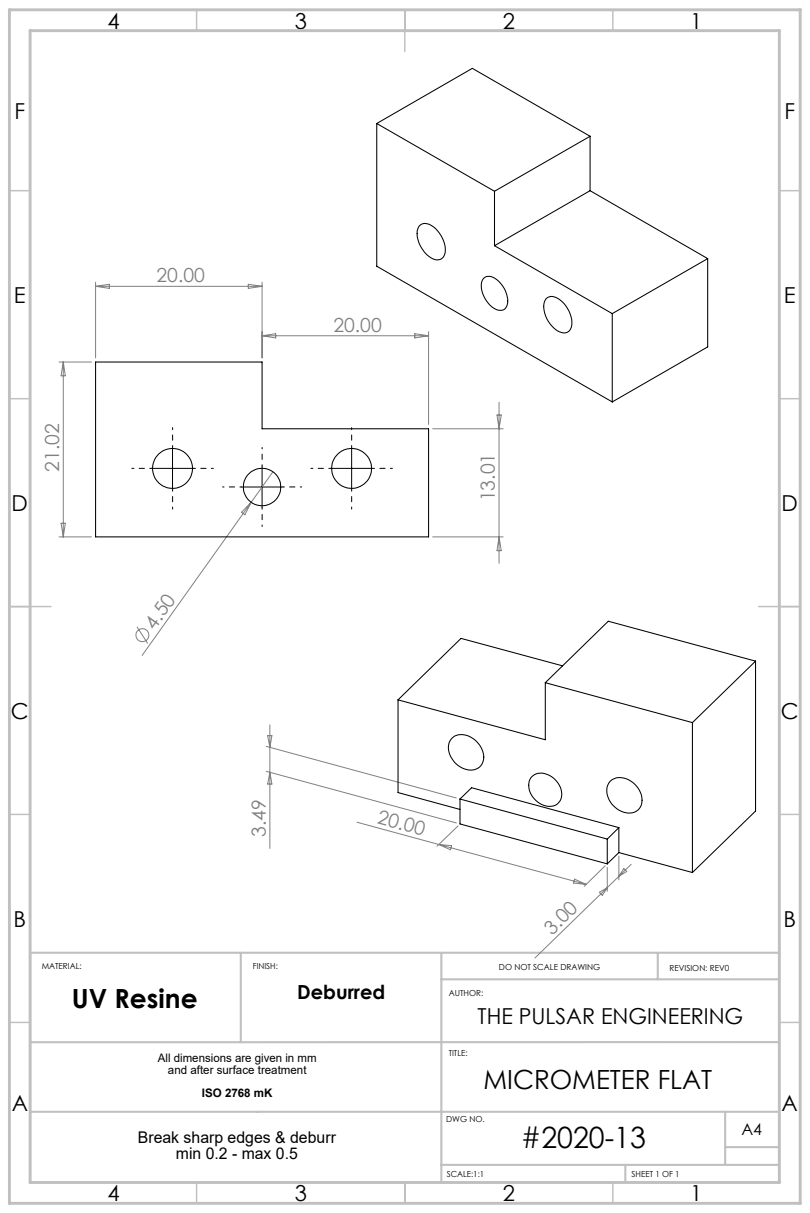
[picture p63: page 1]
MATERIAL:; DO NOT SCALE DRAWING; REVISION: REV0; SCALE:1:1; SHEET 1 OF 1; UV Resine; Deburred

AUTHOR:
THE PULSAR ENGINEERING

All dimensions are given in mm and after surface treatment ISO 2768 mK | TITLE: MICROMETER FLAT

Break sharp edges & deburr min 0.2 - max 0.5 | DWG NO. #2020-13 | A4
