samyk/openraman/software/src/SpectrumAnalyzer/SpectrumAnalyzer/resource.h

//{{NO_DEPENDENCIES}}
// Microsoft Visual C++ generated include file.
// Used by Resource.rc
//
#define IDD_CAMERA                      9
#define IDI_ICON1                       101
#define IDB_BITMAP1                     102
#define IDD_CAM_CONFIG                  103
#define IDD_HELP                        107
#define IDD_ACQUISITION                 109
#define IDD_IMSAVE                      111
#define IDB_SPLASH                      113
#define IDD_CALIBRATE                   114
#define IDR_ICONS	                    116
#define IDC_EXPOSURE_SLIDER             1001
#define IDC_EXPOSURE_EDIT               1002
#define IDC_GAIN_SLIDER                 1003
#define IDC_GAIN_EDIT                   1004
#define IDC_SMOOTHING_SLIDER            1005
#define IDC_SMOOTHING_EDIT              1006
#define IDC_AVERAGE_SLIDER              1007
#define IDC_AVERAGE_EDIT                1008
#define IDC_MEDFILT                     1009
#define IDC_SZ_EXPOSURE                 1010
#define IDC_LOG                         1011
#define IDC_SZ_GAIN                     1012
#define IDC_ROI_SLIDER                  1013
#define IDC_SZ_SMOOTHING                1014
#define IDC_SZ_AVERAGE                  1015
#define IDC_SZ_ROI                      1016
#define IDC_COMBO1                      1017
#define IDC_CAMERA                      1017
#define IDC_AXIS_TYPE                   1017
#define IDC_SOURCE                      1017
#define IDC_OK                          1018
#define IDC_ROI_EDIT                    1018
#define IDC_SZ_STRING                   1019
#define IDC_BASELINE                    1019
#define IDC_ABORT                       1020
#define IDC_SGOLAY                      1020
#define IDC_PROGRESS                    1021
#define IDC_SZ_SGOLAY_WINDOW            1021
#define IDC_SZ_PROGRESS                 1022
#define IDC_SGOLAY_WINDOW_SLIDER        1022
#define IDC_PLOT_TITLE                  1023
#define IDC_SGOLAY_WINDOW_EDIT          1023
#define IDC_CONFIRM_SAVE                1024
#define IDC_SZ_SGOLAY_ORDER             1024
#define IDC_LOG_PATH                    1025
#define IDC_BROWSE                      1026
#define IDC_CAMERA_GROUP                1027
#define IDC_LOG_GROUP                   1028
#define IDC_PLOT_GROUP                  1029
#define IDC_SZ_AXIS                     1030
#define IDC_SZ_RAMAN                    1031
#define IDC_ALGPARAMS_GROUP             1032
#define IDC_SZ2_RAMAN                   1032
#define IDC_SAVE_CALIBRATION            1033
#define IDC_SGOLAY_ORDER_SLIDER         1033
#define IDC_RESET                       1033
#define IDC_SZ_ALIBRATION_OUT           1034
#define IDC_SZ_CALIBRATION_STATUS       1034
#define IDC_SGOLAY_ORDER_EDIT           1034
#define IDC_LOAD_CALIBRATION            1035
#define IDC_SZ_SGOLAY_DERIV             1035
#define IDC_IMPORT_CALIBRATION          1035
#define IDC_CALIBRATE                   1036
#define IDC_SGOLAY_DERIV_SLIDER         1036
#define IDC_SZ_SOURCE                   1037
#define IDC_SGOLAY_DERIV_EDIT           1037
#define IDC_SZ_NUMPEAKS                 1038
#define IDC_SZ_LOGFORMAT                1038
#define IDC_NUMPEAKS_SLIDER             1039
#define IDC_LOGFORMAT                   1039
#define IDC_SZ_NUMPEAKS_VAL             1040
#define IDC_BLANK                       1040
#define IDC_SZ_SENSITIVITY              1041
#define IDC_RAMAN_SLIDER                1041
#define IDC_SENSITIVITY_SLIDER          1042
#define IDC_SZ_SENSITIVITY_VAL          1043
#define IDC_SZ_MODEL                    1044
#define IDC_MODEL                       1045
#define IDC_SZ_MIN                      1046
#define IDC_SZ_MAX                      1047
#define IDC_SZ_DISTORTION               1048
#define IDC_SZ_DISTORTION_MAX           1049
#define IDC_MAX_DISTORTION              1050
#define IDC_SZ_SPAN                     1051
#define IDC_SZ_SPAN_MIN                 1052
#define IDC_MIN_SPAN                    1053
#define IDC_SZ_WAVELENGTH               1054
#define IDC_SZ_WAVELENGTH_MIN           1055
#define IDC_MIN_WAVELENGTH              1056
#define IDC_SZ_WAVELENGTH_MAX           1057
#define IDC_MAX_WAVELENGTH              1058
#define IDC_SZ_SPAN_MAX                 1059
#define IDC_MAX_SPAN                    1060
#define IDC_SZ_DISTORTION_MIN           1061
#define IDC_MIN_DISTORTION              1062
#define IDC_SZ_SAMPLING                 1063
#define IDC_SAMPLING_SLIDER             1064
#define IDC_SZ_SAMPLING_VAL             1065
#define IDC_CALIBRATION_PROGRESS        1066
#define IDC_UPLOAD_CALIBRATION          1069

// Next default values for new objects
// 
#ifdef APSTUDIO_INVOKED
#ifndef APSTUDIO_READONLY_SYMBOLS
#define _APS_NEXT_RESOURCE_VALUE        117
#define _APS_NEXT_COMMAND_VALUE         40001
#define _APS_NEXT_CONTROL_VALUE         1069
#define _APS_NEXT_SYMED_VALUE           101
#endif
#endif
