samyk/openraman/software/src/Interval/Interval/resource.h

//{{NO_DEPENDENCIES}}
// Microsoft Visual C++ generated include file.
// Used by Resource.rc
//
#define IDD_DIALOG                      101
#define IDR_RT_MANIFEST1                103
#define IDI_ICON1                       104
#define IDC_SETTINGS_GROUP              1001
#define IDC_DELAY_EDIT                  1002
#define IDC_DELAY_LIST                  1003
#define IDC_INFINITE                    1004
#define IDC_FINITE                      1005
#define IDC_NUMLOOPS                    1006
#define IDC_CHECK1                      1008
#define IDC_RUN                         1008
#define IDC_SZ_DELAY                    1009
#define IDC_SZ_LOOPS                    1010
#define IDC_STATUS                      1011

// Next default values for new objects
// 
#ifdef APSTUDIO_INVOKED
#ifndef APSTUDIO_READONLY_SYMBOLS
#define _APS_NEXT_RESOURCE_VALUE        105
#define _APS_NEXT_COMMAND_VALUE         40001
#define _APS_NEXT_CONTROL_VALUE         1012
#define _APS_NEXT_SYMED_VALUE           101
#endif
#endif
