samyk/openraman/software/src/evemon/evemon/shared/gui/axis.h

#pragma once
#pragma warning(disable:26451)
#include <string>
#include <functional>
#include <windows.h>
#include "../utils/utils.h"
#include "gui.h"
#include "brush.h"
#include "pen.h"
#include "text.h"
#define DEFAULT_MAJOR_GRID_LINE_THICKNESS		2
#define DEFAULT_MAJOR_GRID_LINE_COLOR			RGB(128,128,128)
#define DEFAULT_MINOR_GRID_LINE_THICKNESS		1
#define DEFAULT_MINOR_GRID_LINE_COLOR			RGB(192,192,192)
#define DEFAULT_MAJOR_TICKS_LINE_THICKNESS		2
#define DEFAULT_MAJOR_TICKS_LINE_EXTEND			7
#define DEFAULT_MAJOR_TICKS_LINE_COLOR			RGB(0,0,0)
#define DEFAULT_MINOR_TICKS_LINE_THICKNESS		1
#define DEFAULT_MINOR_TICKS_LINE_EXTEND			5
#define DEFAULT_MINOR_TICKS_LINE_COLOR			RGB(128,128,128)
class guiAxis
{
public:
	enum class Type
	{
		Horizontal,
		Vertical,
	};
	guiAxis(Type eType, double fMin=0, double fMax=0)
	{
		this->minval = fMin;
		this->maxval = fMax;
		this->m_eType = eType;
	}
	bool map(const RECT& rRect, double fValue, int& rRetValue) const
	{
		if (fabs(this->minval - this->maxval) < 1e-15)
			return false;
		switch (this->m_eType)
		{
		case Type::Horizontal:
			rRetValue = rRect.left + (int)round((double)(rRect.right - rRect.left) * (fValue - this->minval) / (this->maxval - this->minval));
			return true;
		case Type::Vertical:
			rRetValue = rRect.top + (int)round((double)(rRect.bottom - rRect.top) * (this->maxval - fValue) / (this->maxval - this->minval));
			return true;
		default:
			return false;
		}
	}
	double minval, maxval;
protected:
	double computeUIStepSize(const RECT& rRect, double fAxisStepSize, double& fRetValue) const
	{
		if (fabs(this->minval - this->maxval) < 1e-15)
			return false;
		switch (this->m_eType)
		{
		case Type::Horizontal:
			fRetValue = (double)(rRect.right - rRect.left) * fAxisStepSize / (this->maxval - this->minval);
			return fabs(fRetValue) > 1e-15;
		case Type::Vertical:
			fRetValue = (double)(rRect.bottom - rRect.top) * fAxisStepSize / (this->maxval - this->minval);
			return fabs(fRetValue) > 1e-15;
		default:
			return false;
		}
	}
	Type m_eType;
};
class guiIRenderAxis : public guiAxis
{
public:
	class guiTicksPen : public guiPen
	{
	public:
		guiTicksPen(void)
		{
			this->extend = 0;
		}
		int extend;
	};
	class guiLabels : public guiText
	{
	public:
		std::function<std::string(double)> format;
	};
	guiIRenderAxis(Type eType) : guiAxis(eType)
	{
		this->major = 0;
		this->minor = 0;
		this->grid.render_enable = true;
		this->grid.major.thickness = DEFAULT_MAJOR_GRID_LINE_THICKNESS;
		this->grid.major.color = DEFAULT_MAJOR_GRID_LINE_COLOR;
		this->grid.minor.thickness = DEFAULT_MINOR_GRID_LINE_THICKNESS;
		this->grid.minor.color = DEFAULT_MINOR_GRID_LINE_COLOR;
		this->ticks.major.thickness = DEFAULT_MAJOR_TICKS_LINE_THICKNESS;
		this->ticks.major.extend = DEFAULT_MAJOR_TICKS_LINE_EXTEND;
		this->ticks.major.color = DEFAULT_MAJOR_TICKS_LINE_COLOR;
		this->ticks.minor.thickness = DEFAULT_MINOR_TICKS_LINE_THICKNESS;
		this->ticks.minor.extend = DEFAULT_MINOR_TICKS_LINE_EXTEND;
		this->ticks.minor.color = DEFAULT_MINOR_TICKS_LINE_COLOR;
		this->render_enable = false;
	}
	void renderMajorGrid(HDC hDC, const RECT& rRect) const
	{
		if (!this->render_enable || !this->grid.render_enable)
			return;
		if (this->grid.major.type.get() == guiPen::Type::None)
			return;
		AUTOPEN(hDC, this->grid.major);
		double fUIStepSize;
		if (computeUIStepSize(rRect, this->major, fUIStepSize))
			renderGrid(hDC, rRect, fUIStepSize);
	}
	void renderMinorGrid(HDC hDC, const RECT& rRect) const
	{
		if (!this->render_enable || !this->grid.render_enable)
			return;
		if (this->grid.minor.type.get() == guiPen::Type::None)
			return;
		AUTOPEN(hDC, this->grid.minor);
		double fUIStepSize;
		if (computeUIStepSize(rRect, this->minor, fUIStepSize))
			renderGrid(hDC, rRect, fUIStepSize);
	}
	void renderMajorTicks(HDC hDC, const RECT& rRect) const
	{
		if (!this->render_enable)
			return;
		if (this->ticks.major.type.get() == guiPen::Type::None)
			return;
		AUTOPEN(hDC, this->ticks.major);
		double fUIStepSize;
		if (computeUIStepSize(rRect, this->major, fUIStepSize))
			renderTicks(hDC, rRect, fUIStepSize, this->ticks.major.extend);
	}
	void renderMinorTicks(HDC hDC, const RECT& rRect) const
	{
		if (!this->render_enable)
			return;
		if (this->ticks.minor.type.get() == guiPen::Type::None)
			return;
		AUTOPEN(hDC, this->ticks.minor);
		double fUIStepSize;
		if (computeUIStepSize(rRect, this->minor, fUIStepSize))
			renderTicks(hDC, rRect, fUIStepSize, this->ticks.minor.extend);
	}
	int calcLabelsMargin(HDC hDC) const
	{
		AUTOFONT(hDC, this->labels.font);
		if (!this->labels.format)
			return 0;
		double fMin = min(this->minval, this->maxval);
		double fMax = max(this->minval, this->maxval);
		SIZE results = { 0, 0 };
		for (double i = fMin; i <= fMax; i += fabs(this->major))
		{
			this->labels.text = this->labels.format(i);
			int  w, h;
			if (!this->labels.calcRect(hDC, w, h))
				continue;
			results.cx = max(results.cx, w);
			results.cy = max(results.cy, h);
		}
		switch (this->m_eType)
		{
		case Type::Horizontal:
			return results.cy;
		case Type::Vertical:
			return results.cx;
		}
		return 0;
	}
	virtual void renderLabels(HDC hDC, const RECT& rRect) const = 0;
	struct
	{
		guiPen major, minor;
		bool render_enable;
	} grid;
	struct
	{
		guiTicksPen major, minor;
	} ticks;
	mutable guiLabels labels;
	guiText title;
	double major, minor;
	bool render_enable;
protected:
	virtual void renderGrid(HDC hDC, const RECT& rRect, double fUIStepSize) const = 0;
	virtual void renderTicks(HDC hDC, const RECT& rRect, double fUIStepSize, int iTickSize) const = 0;
};
class guiPrimaryHorizontalAxis : public guiIRenderAxis
{
public:
	guiPrimaryHorizontalAxis(void) : guiIRenderAxis(Type::Horizontal) { }
	virtual void renderLabels(HDC hDC, const RECT& rRect) const override
	{
		if (!this->labels.format)
			return;
		AUTOFONT(hDC, this->labels.font);
		double fUIStepSize;
		if (!computeUIStepSize(rRect, this->major, fUIStepSize))
			return;
		for (double x = (double)rRect.left, x2 = this->minval; x < (double)(rRect.right+1); x += fabs(fUIStepSize), x2 += this->major * sign(this->maxval - this->minval))
		{
			this->labels.text = this->labels.format(x2);
			int  w, h;
			if (!this->labels.calcRect(hDC, w, h))
				continue;
			RECT rect;
			rect.left = (int)x - w / 2;
			rect.right = rect.left + w;
			rect.top = rRect.top;
			rect.bottom = rRect.bottom;
			this->labels.render(hDC, rect);
		}
	}
protected:
	virtual void renderGrid(HDC hDC, const RECT &rRect, double fUIStepSize) const override
	{
		for (double x = (double)rRect.left; x < (double)(rRect.right+1); x += fabs(fUIStepSize))
			drawLine(hDC, (int)x, rRect.top, (int)x, rRect.bottom);
	}
	virtual void renderTicks(HDC hDC, const RECT &rRect, double fUIStepSize, int iTickSize) const override
	{
		for (double x = (double)rRect.left; x < (double)(rRect.right+1); x += fabs(fUIStepSize))
			drawLine(hDC, (int)x, rRect.bottom, (int)x, rRect.bottom + iTickSize);
	}
};
class guiPrimaryVerticalAxis : public guiIRenderAxis
{
public:
	guiPrimaryVerticalAxis(void) : guiIRenderAxis(Type::Vertical) { }
	virtual void renderLabels(HDC hDC, const RECT& rRect) const override
	{
		if (!this->labels.format)
			return;
		AUTOFONT(hDC, this->labels.font);
		double fUIStepSize;
		if (!computeUIStepSize(rRect, this->major, fUIStepSize))
			return;
		for (double y = (double)rRect.bottom, y2 = this->minval; y > (double)(rRect.top + 1); y -= fabs(fUIStepSize), y2 += this->major * sign(this->maxval - this->minval))
		{
			this->labels.text = this->labels.format(y2);
			int  w, h;
			if (!this->labels.calcRect(hDC, w, h))
				continue;
			RECT rect;
			rect.left = rRect.left;
			rect.right = rRect.right;
			rect.top = (int)y - h / 2;
			rect.bottom = rect.top + h;
			this->labels.render(hDC, rect);
		}
	}
protected:
	virtual void renderGrid(HDC hDC, const RECT& rRect, double fUIStepSize) const override
	{
		for (double y = (double)rRect.bottom; y > (double)(rRect.top + 1); y -= fabs(fUIStepSize))
			drawLine(hDC, rRect.left, (int)y, rRect.right, (int)y);
	}
	virtual void renderTicks(HDC hDC, const RECT& rRect, double fUIStepSize, int iTickSize) const override
	{
		for (double y = (double)rRect.bottom; y >= (double)(rRect.top + 1); y -= fabs(fUIStepSize))
			drawLine(hDC, rRect.left - iTickSize, (int)y, rRect.left, (int)y);
	}
};
class guiSecondaryHorizontalAxis : public guiIRenderAxis
{
public:
	guiSecondaryHorizontalAxis(void) : guiIRenderAxis(Type::Horizontal) { }
	virtual void renderLabels(HDC hDC, const RECT& rRect) const override
	{
		if (!this->labels.format)
			return;
		AUTOFONT(hDC, this->labels.font);
		double fUIStepSize;
		if (!computeUIStepSize(rRect, this->major, fUIStepSize))
			return;
		for (double x = (double)rRect.left, x2 = this->minval; x < (double)(rRect.right + 1); x += fabs(fUIStepSize), x2 += this->major * sign(this->maxval - this->minval))
		{
			this->labels.text = this->labels.format(x2);
			int  w, h;
			if (!this->labels.calcRect(hDC, w, h))
				continue;
			RECT rect;
			rect.left = (int)x - w / 2;
			rect.right = rect.left + w;
			rect.top = rRect.top;
			rect.bottom = rRect.bottom;
			this->labels.render(hDC, rect);
		}
	}
protected:
	virtual void renderGrid(HDC hDC, const RECT& rRect, double fUIStepSize) const override
	{
		for (double x = (double)rRect.left; x < (double)(rRect.right + 1); x += fabs(fUIStepSize))
			drawLine(hDC, (int)x, rRect.top, (int)x, rRect.bottom);
	}
	virtual void renderTicks(HDC hDC, const RECT& rRect, double fUIStepSize, int iTickSize) const override
	{
		for (double x = (double)rRect.left; x <= (double)(rRect.right + 1); x += fabs(fUIStepSize))
			drawLine(hDC, (int)x, rRect.top, (int)x, rRect.top - iTickSize);
	}
};
class guiSecondaryVerticalAxis : public guiIRenderAxis
{
public:
	guiSecondaryVerticalAxis(void) : guiIRenderAxis(Type::Vertical) { }
	virtual void renderLabels(HDC hDC, const RECT& rRect) const override
	{
		if (!this->labels.format)
			return;
		AUTOFONT(hDC, this->labels.font);
		double fUIStepSize;
		if (!computeUIStepSize(rRect, this->major, fUIStepSize))
			return;
		for (double y = (double)rRect.bottom, y2 = this->minval; y > (double)(rRect.top + 1); y -= fabs(fUIStepSize), y2 += this->major * sign(this->maxval - this->minval))
		{
			this->labels.text = this->labels.format(y2);
			int  w, h;
			if (!this->labels.calcRect(hDC, w, h))
				continue;
			RECT rect;
			rect.left = rRect.left;
			rect.right = rRect.right;
			rect.top = (int)y - h / 2;
			rect.bottom = rect.top + h;
			this->labels.render(hDC, rect);
		}
	}
protected:
	virtual void renderGrid(HDC hDC, const RECT& rRect, double fUIStepSize) const override
	{
		for (double y = (double)rRect.bottom; y > (double)(rRect.top + 1); y -= fabs(fUIStepSize))
			drawLine(hDC, rRect.left, (int)y, rRect.right, (int)y);
	}
	virtual void renderTicks(HDC hDC, const RECT& rRect, double fUIStepSize, int iTickSize) const override
	{
		for (double y = (double)rRect.bottom; y >= (double)(rRect.top + 1); y -= fabs(fUIStepSize))
			drawLine(hDC, rRect.right, (int)y, rRect.right + iTickSize, (int)y);
	}
};
