samyk/openraman/(commit log)

2023-12-25 added solid and standard cuvettes
    [2020-08_0 - CUVETTE HOLDER BODY.STEP, 2020-09_0 - CUVETTE HOLDER CAP.STEP, 2020-10_1 - CUVETTE HOLDER ASSY.STEP, 2020-10_1 - CUVETTE HOLDER ASSY.csv, 2021-09_0 - SOLID ASSY.csv, 2021-10_0 - COUPELLE.STEP, 2021-11_0 - COUPELLE ASSY.STEP, 2021-11_0 - COUPELLE ASSY.csv]
2023-12-25 add performence version rev2
    [2020-01_2 - CAMERA BRACKET.STEP, 2020-02_2 - BASE PLATE.STEP, 2020-04_2 - PERFORMANCE EDITION ASSY.csv, 2020-12_1 - LD CLAMP.STEP, 2020-15_1 - GRATING HOLDER.STEP, 2020-18_1 - LASER ASSY.csv, 2020-19_ASSY_2 - LD TEC DRIVER.csv, 2020-20_1 - TO92 HEATSINK.STEP]
